danieldegrasse/Flexboard/BOM.xlsx

Sheet: Parts
Part | Value | Device | Package | Description | AVAILABILITY | CATEGORY | COMMENT | CONFIGURATION_POLE-THROW | CONTACT_CURRENT_RATING | CPU | DESCRIPTION | DIGI-KEY_PART_NUMBER | EU_ROHS_COMPLIANCE | FLASHKB | MANUFACTURER | MANUFACTURER_PART_NUMBER | MAXFREQUENCY | MF | MP | MPN | OC_FARNELL | OC_NEWARK | OPERATING_TEMP | PACKAGE | PART_STATUS | PINCOUNT | POPULARITY | POWER_RATING | PRICE | PURCHASE-URL | RATING | RESISTANCE | ROHS_COMPLIANT | SERIES | SRAMKB | SUB-CATEGORY | THERMALLOSS | TOLERANCE | TP_SIGNAL_NAME | TYPE | VENDOR | VOLTAGE_RATING
C1 | 1000pF | C1206C102K1RACAUTO | CAPC3216X110N | Cap Ceramic 0.001uF 100V X7R 10% SMD 1206 125°C Plastic T/R Check availability | In Stock |  |  |  |  |  | 1000 pF ±10% 100V Ceramic Capacitor X7R 1206 (3216 Metric) |  |  |  |  |  |  | KEMET | C1206C102K1RACAUTO |  |  |  |  | 1206 KEMET |  |  |  |  | None | https://pricing.snapeda.com/search/part/C1206C102K1RACAUTO/?ref=eda
C2 | 1uF | GCM31MR71H105KA55L | CAPC3216X125N | None Check availability | In Stock |  |  |  |  |  | SMD Capacitor X7R(EIA) with Capacitance: 1.0uF Tol. 10%. Rated Voltage: 50Vdc |  |  |  |  |  |  | Murata | GCM31MR71H105KA55L |  |  |  |  | 1206 Murata |  |  |  |  | None | https://pricing.snapeda.com/search/part/GCM31MR71H105KA55L/?ref=eda
C3 | 1uF | GCM31MR71H105KA55L | CAPC3216X125N | None Check availability | In Stock |  |  |  |  |  | SMD Capacitor X7R(EIA) with Capacitance: 1.0uF Tol. 10%. Rated Voltage: 50Vdc |  |  |  |  |  |  | Murata | GCM31MR71H105KA55L |  |  |  |  | 1206 Murata |  |  |  |  | None | https://pricing.snapeda.com/search/part/GCM31MR71H105KA55L/?ref=eda
C4 | 1uF | GCM31MR71H105KA55L | CAPC3216X125N | None Check availability | In Stock |  |  |  |  |  | SMD Capacitor X7R(EIA) with Capacitance: 1.0uF Tol. 10%. Rated Voltage: 50Vdc |  |  |  |  |  |  | Murata | GCM31MR71H105KA55L |  |  |  |  | 1206 Murata |  |  |  |  | None | https://pricing.snapeda.com/search/part/GCM31MR71H105KA55L/?ref=eda
C5 | 100nF | C1206C104K5RAC7800 | CAPC3216X88N | Cap Ceramic 0.1uF 50V X7R 10% SMD 1206 125C Plastic T/R Check availability | In Stock |  |  |  |  |  | 0.1 µF ±10% 50V Ceramic Capacitor X7R 1206 (3216 Metric) |  |  |  |  |  |  | KEMET | C1206C104K5RAC7800 |  |  |  |  | 3216 KEMET |  |  |  |  | None | https://pricing.snapeda.com/search/part/C1206C104K5RAC7800/?ref=eda
C6 | 100nF | C1206C104K5RAC7800 | CAPC3216X88N | Cap Ceramic 0.1uF 50V X7R 10% SMD 1206 125C Plastic T/R Check availability | In Stock |  |  |  |  |  | 0.1 µF ±10% 50V Ceramic Capacitor X7R 1206 (3216 Metric) |  |  |  |  |  |  | KEMET | C1206C104K5RAC7800 |  |  |  |  | 3216 KEMET |  |  |  |  | None | https://pricing.snapeda.com/search/part/C1206C104K5RAC7800/?ref=eda
C7 | 100nF | C1206C104K5RAC7800 | CAPC3216X88N | Cap Ceramic 0.1uF 50V X7R 10% SMD 1206 125C Plastic T/R Check availability | In Stock |  |  |  |  |  | 0.1 µF ±10% 50V Ceramic Capacitor X7R 1206 (3216 Metric) |  |  |  |  |  |  | KEMET | C1206C104K5RAC7800 |  |  |  |  | 3216 KEMET |  |  |  |  | None | https://pricing.snapeda.com/search/part/C1206C104K5RAC7800/?ref=eda
C8 | 1uF | GCM31MR71H105KA55L | CAPC3216X125N | None Check availability | In Stock |  |  |  |  |  | SMD Capacitor X7R(EIA) with Capacitance: 1.0uF Tol. 10%. Rated Voltage: 50Vdc |  |  |  |  |  |  | Murata | GCM31MR71H105KA55L |  |  |  |  | 1206 Murata |  |  |  |  | None | https://pricing.snapeda.com/search/part/GCM31MR71H105KA55L/?ref=eda
C9 | 100nF | C1206C104K5RAC7800 | CAPC3216X88N | Cap Ceramic 0.1uF 50V X7R 10% SMD 1206 125C Plastic T/R Check availability | In Stock |  |  |  |  |  | 0.1 µF ±10% 50V Ceramic Capacitor X7R 1206 (3216 Metric) |  |  |  |  |  |  | KEMET | C1206C104K5RAC7800 |  |  |  |  | 3216 KEMET |  |  |  |  | None | https://pricing.snapeda.com/search/part/C1206C104K5RAC7800/?ref=eda
C10 | 22pF | C1206C220JGGAC7800 | CAPC3216X110N | Check availability | In Stock |  |  |  |  |  | CAP CER 22PF 2KV NP0 1206 |  |  |  |  |  |  | KEMET | C1206C220JGGAC7800 |  |  |  |  | 3216 KEMET |  |  |  |  | None
C11 | 22pF | C1206C220JGGAC7800 | CAPC3216X110N | Check availability | In Stock |  |  |  |  |  | CAP CER 22PF 2KV NP0 1206 |  |  |  |  |  |  | KEMET | C1206C220JGGAC7800 |  |  |  |  | 3216 KEMET |  |  |  |  | None
C12 | 2.2uF | 1206ZC225MAT2A | CAPC3216X178N | CERAMIC CAPACITOR, 2.2UF, 10V, X7R, 20%, 1206, FULL REEL Check availability | In Stock |  |  |  |  |  | 2.2 µF ±20% 10V Ceramic Capacitor X7R 1206 (3216 Metric) |  |  |  |  |  |  | AVX | 1206ZC225MAT2A |  |  |  |  | 3216 AVX |  |  |  |  | None | https://pricing.snapeda.com/search/part/1206ZC225MAT2A/?ref=eda
C13 | 10uF | GRM21BC8YA106ME11L | CAPC2012X145N | Cap Ceramic 10uF 35V X6S 20% Pad SMD 0805 105C T/R |  |  |  |  |  |  | 0805 10 uF 35 V ±20% Tolerance X6S Multilayer Ceramic Capacitor | 490-10505-2-ND |  |  |  |  |  | Murata | GRM21BC8YA106ME11L |  |  |  |  | 2012 Murata |  |  |  |  |  | https://pricing.snapeda.com/search/part/GRM21BC8YA106ME11L/?ref=eda
C14 | 10uF | GRM21BC8YA106ME11L | CAPC2012X145N | Cap Ceramic 10uF 35V X6S 20% Pad SMD 0805 105C T/R |  |  |  |  |  |  | 0805 10 uF 35 V ±20% Tolerance X6S Multilayer Ceramic Capacitor | 490-10505-2-ND |  |  |  |  |  | Murata | GRM21BC8YA106ME11L |  |  |  |  | 2012 Murata |  |  |  |  |  | https://pricing.snapeda.com/search/part/GRM21BC8YA106ME11L/?ref=eda
C15 | 1000pF | C1206C102K1RACAUTO | CAPC3216X110N | Cap Ceramic 0.001uF 100V X7R 10% SMD 1206 125°C Plastic T/R Check availability | In Stock |  |  |  |  |  | 1000 pF ±10% 100V Ceramic Capacitor X7R 1206 (3216 Metric) |  |  |  |  |  |  | KEMET | C1206C102K1RACAUTO |  |  |  |  | 1206 KEMET |  |  |  |  | None | https://pricing.snapeda.com/search/part/C1206C102K1RACAUTO/?ref=eda
C16 | 0.47uF | C_CHIP-0805(2012-METRIC) | CAPC2012X110 | Capacitor - Generic |  | Capacitor
C17 | 0.47uF | C_CHIP-0805(2012-METRIC) | CAPC2012X110 | Capacitor - Generic |  | Capacitor
C18 | 0.1uF | C_CHIP-0805(2012-METRIC) | CAPC2012X110 | Capacitor - Generic |  | Capacitor
C19 | 0.47uF | C_CHIP-0805(2012-METRIC) | CAPC2012X110 | Capacitor - Generic |  | Capacitor
C20 | 0.1uF | C_CHIP-0805(2012-METRIC) | CAPC2012X110 | Capacitor - Generic |  | Capacitor
C21 | 0.47uF | C_CHIP-0805(2012-METRIC) | CAPC2012X110 | Capacitor - Generic |  | Capacitor
C22 | 0.1uF | C_CHIP-0805(2012-METRIC) | CAPC2012X110 | Capacitor - Generic |  | Capacitor
C23 | 22uF | 860020672011 | 860020672011 | 22uF 50V Electrolytic Capacitor Wurth 860020672011
C24 | 12pF | C_CHIP-0805(2012-METRIC) | CAPC2012X110 | Capacitor - Generic |  | Capacitor
C25 | 12pF | C_CHIP-0805(2012-METRIC) | CAPC2012X110 | Capacitor - Generic |  | Capacitor
D1 | BAS16LT3G | BAS16LT3G | SOT95P240X111-3N | Diode Small Signal Switching 100V 0.2A Automotive 3-Pin SOT-23 T/R Check prices | In Stock |  |  |  |  |  | Diode Standard 100V 200mA (DC) Surface Mount SOT-23-3 (TO-236) |  |  |  |  |  |  | ON Semiconductor | BAS16LT3G |  |  |  |  | SOT-23-3 ON Semiconductor |  |  |  |  | None
D2 | BAS16LT3G | BAS16LT3G | SOT95P240X111-3N | Diode Small Signal Switching 100V 0.2A Automotive 3-Pin SOT-23 T/R Check prices | In Stock |  |  |  |  |  | Diode Standard 100V 200mA (DC) Surface Mount SOT-23-3 (TO-236) |  |  |  |  |  |  | ON Semiconductor | BAS16LT3G |  |  |  |  | SOT-23-3 ON Semiconductor |  |  |  |  | None
D3 | BAS16LT3G | BAS16LT3G | SOT95P240X111-3N | Diode Small Signal Switching 100V 0.2A Automotive 3-Pin SOT-23 T/R Check prices | In Stock |  |  |  |  |  | Diode Standard 100V 200mA (DC) Surface Mount SOT-23-3 (TO-236) |  |  |  |  |  |  | ON Semiconductor | BAS16LT3G |  |  |  |  | SOT-23-3 ON Semiconductor |  |  |  |  | None
D4 | BAS16LT3G | BAS16LT3G | SOT95P240X111-3N | Diode Small Signal Switching 100V 0.2A Automotive 3-Pin SOT-23 T/R Check prices | In Stock |  |  |  |  |  | Diode Standard 100V 200mA (DC) Surface Mount SOT-23-3 (TO-236) |  |  |  |  |  |  | ON Semiconductor | BAS16LT3G |  |  |  |  | SOT-23-3 ON Semiconductor |  |  |  |  | None
D5 | BAS16LT3G | BAS16LT3G | SOT95P240X111-3N | Diode Small Signal Switching 100V 0.2A Automotive 3-Pin SOT-23 T/R Check prices | In Stock |  |  |  |  |  | Diode Standard 100V 200mA (DC) Surface Mount SOT-23-3 (TO-236) |  |  |  |  |  |  | ON Semiconductor | BAS16LT3G |  |  |  |  | SOT-23-3 ON Semiconductor |  |  |  |  | None
D6 | BAS16LT3G | BAS16LT3G | SOT95P240X111-3N | Diode Small Signal Switching 100V 0.2A Automotive 3-Pin SOT-23 T/R Check prices | In Stock |  |  |  |  |  | Diode Standard 100V 200mA (DC) Surface Mount SOT-23-3 (TO-236) |  |  |  |  |  |  | ON Semiconductor | BAS16LT3G |  |  |  |  | SOT-23-3 ON Semiconductor |  |  |  |  | None
D7 | BAS16LT3G | BAS16LT3G | SOT95P240X111-3N | Diode Small Signal Switching 100V 0.2A Automotive 3-Pin SOT-23 T/R Check prices | In Stock |  |  |  |  |  | Diode Standard 100V 200mA (DC) Surface Mount SOT-23-3 (TO-236) |  |  |  |  |  |  | ON Semiconductor | BAS16LT3G |  |  |  |  | SOT-23-3 ON Semiconductor |  |  |  |  | None
D8 | BAS16LT3G | BAS16LT3G | SOT95P240X111-3N | Diode Small Signal Switching 100V 0.2A Automotive 3-Pin SOT-23 T/R Check prices | In Stock |  |  |  |  |  | Diode Standard 100V 200mA (DC) Surface Mount SOT-23-3 (TO-236) |  |  |  |  |  |  | ON Semiconductor | BAS16LT3G |  |  |  |  | SOT-23-3 ON Semiconductor |  |  |  |  | None
D9 | BAS16LT3G | BAS16LT3G | SOT95P240X111-3N | Diode Small Signal Switching 100V 0.2A Automotive 3-Pin SOT-23 T/R Check prices | In Stock |  |  |  |  |  | Diode Standard 100V 200mA (DC) Surface Mount SOT-23-3 (TO-236) |  |  |  |  |  |  | ON Semiconductor | BAS16LT3G |  |  |  |  | SOT-23-3 ON Semiconductor |  |  |  |  | None
D10 | BAS16LT3G | BAS16LT3G | SOT95P240X111-3N | Diode Small Signal Switching 100V 0.2A Automotive 3-Pin SOT-23 T/R Check prices | In Stock |  |  |  |  |  | Diode Standard 100V 200mA (DC) Surface Mount SOT-23-3 (TO-236) |  |  |  |  |  |  | ON Semiconductor | BAS16LT3G |  |  |  |  | SOT-23-3 ON Semiconductor |  |  |  |  | None
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
D151 | BAS16LT3G | BAS16LT3G | SOT95P240X111-3N | Diode Small Signal Switching 100V 0.2A Automotive 3-Pin SOT-23 T/R Check prices | In Stock |  |  |  |  |  | Diode Standard 100V 200mA (DC) Surface Mount SOT-23-3 (TO-236) |  |  |  |  |  |  | ON Semiconductor | BAS16LT3G |  |  |  |  | SOT-23-3 ON Semiconductor |  |  |  |  | None
D152 | BAS16LT3G | BAS16LT3G | SOT95P240X111-3N | Diode Small Signal Switching 100V 0.2A Automotive 3-Pin SOT-23 T/R Check prices | In Stock |  |  |  |  |  | Diode Standard 100V 200mA (DC) Surface Mount SOT-23-3 (TO-236) |  |  |  |  |  |  | ON Semiconductor | BAS16LT3G |  |  |  |  | SOT-23-3 ON Semiconductor |  |  |  |  | None
D153 | BAS16LT3G | BAS16LT3G | SOT95P240X111-3N | Diode Small Signal Switching 100V 0.2A Automotive 3-Pin SOT-23 T/R Check prices | In Stock |  |  |  |  |  | Diode Standard 100V 200mA (DC) Surface Mount SOT-23-3 (TO-236) |  |  |  |  |  |  | ON Semiconductor | BAS16LT3G |  |  |  |  | SOT-23-3 ON Semiconductor |  |  |  |  | None
D154 | LSM115JE3/TR13 | LSM115JE3/TR13 | LSM115JE3/TR13 | LSM115JE3/TR13
GND1 | TPB2,54 | TPB2,54 | B2,54 | Test pad |  |  |  |  |  |  |  |  |  |  |  |  |  |  |  |  |  |  |  |  |  |  | 3
GND2 | TPB2,54 | TPB2,54 | B2,54 | Test pad |  |  |  |  |  |  |  |  |  |  |  |  |  |  |  |  |  |  |  |  |  |  | 3
GND3 | TPB2,54 | TPB2,54 | B2,54 | Test pad |  |  |  |  |  |  |  |  |  |  |  |  |  |  |  |  |  |  |  |  |  |  | 3
GND4 | TPB2,54 | TPB2,54 | B2,54 | Test pad |  |  |  |  |  |  |  |  |  |  |  |  |  |  |  |  |  |  |  |  |  |  | 3
J1 | USB4105-GF-A | USB4105-GF-A | GCT_USB4105-GF-A | USB-C (USB TYPE-C) USB 2.0 Receptacle Connector 24 (16+8 Dummy) Position Surface Mount, Right Angle; Through Hole Check availability | In Stock |  |  |  |  |  | USB-C (USB TYPE-C) USB 2.0 Receptacle Connector 24 (16+8 Dummy) Position Surface Mount, Right Angle | Through Hole |  |  |  |  |  |  | GCT | USB4105-GF-A |  |  |  |  | None |  |  |  |  | None | https://pricing.snapeda.com/search/part/USB4105-GF-A/?ref=eda
J2 | GRPB052VWQS-RC | GRPB052VWQS-RC | DEBUG | CONN HEADER 0.050" 10PS DL SMD AU | In Stock |  |  |  |  |  | Connector Header Surface Mount 10 position 0.050 (1.27mm) |  |  |  |  |  |  | Sullins Connector | GRPB052VWQS-RC |  |  |  |  | None |  |  |  |  | None | https://pricing.snapeda.com/search/part/GRPB052VWQS-RC/?ref=eda
KEY_1 | CHERRY-MX-LED | CHERRY-MX-LED | CHERRY-MX-LED | Cherry MX series keyswitch with LED
KEY_2 | CHERRY-MX-LED | CHERRY-MX-LED | CHERRY-MX-LED | Cherry MX series keyswitch with LED
KEY_3 | CHERRY-MX-LED | CHERRY-MX-LED | CHERRY-MX-LED | Cherry MX series keyswitch with LED
KEY_4 | CHERRY-MX-LED | CHERRY-MX-LED | CHERRY-MX-LED | Cherry MX series keyswitch with LED
KEY_5 | CHERRY-MX-LED | CHERRY-MX-LED | CHERRY-MX-LED | Cherry MX series keyswitch with LED
KEY_6 | CHERRY-MX-LED | CHERRY-MX-LED | CHERRY-MX-LED | Cherry MX series keyswitch with LED
KEY_7 | CHERRY-MX-LED | CHERRY-MX-LED | CHERRY-MX-LED | Cherry MX series keyswitch with LED
KEY_8 | CHERRY-MX-LED | CHERRY-MX-LED | CHERRY-MX-LED | Cherry MX series keyswitch with LED
KEY_9 | CHERRY-MX-LED | CHERRY-MX-LED | CHERRY-MX-LED | Cherry MX series keyswitch with LED
KEY_10 | CHERRY-MX-LED | CHERRY-MX-LED | CHERRY-MX-LED | Cherry MX series keyswitch with LED
KEY_11 | CHERRY-MX-LED | CHERRY-MX-LED | CHERRY-MX-LED | Cherry MX series keyswitch with LED
KEY_12 | CHERRY-MX-LED | CHERRY-MX-LED | CHERRY-MX-LED | Cherry MX series keyswitch with LED
KEY_13 | CHERRY-MX-LED | CHERRY-MX-LED | CHERRY-MX-LED | Cherry MX series keyswitch with LED
KEY_14 | CHERRY-MX-LED | CHERRY-MX-LED | CHERRY-MX-LED | Cherry MX series keyswitch with LED
KEY_15 | CHERRY-MX-LED | CHERRY-MX-LED | CHERRY-MX-LED | Cherry MX series keyswitch with LED
KEY_16 | CHERRY-MX-LED | CHERRY-MX-LED | CHERRY-MX-LED | Cherry MX series keyswitch with LED
KEY_17 | CHERRY-MX-LED | CHERRY-MX-LED | CHERRY-MX-LED | Cherry MX series keyswitch with LED
KEY_18 | CHERRY-MX-LED | CHERRY-MX-LED | CHERRY-MX-LED | Cherry MX series keyswitch with LED
KEY_19 | CHERRY-MX-LED | CHERRY-MX-LED | CHERRY-MX-LED | Cherry MX series keyswitch with LED
KEY_20 | CHERRY-MX-LED | CHERRY-MX-LED | CHERRY-MX-LED | Cherry MX series keyswitch with LED
KEY_21 | CHERRY-MX-LED | CHERRY-MX-LED | CHERRY-MX-LED | Cherry MX series keyswitch with LED
KEY_22 | CHERRY-MX-LED | CHERRY-MX-LED | CHERRY-MX-LED | Cherry MX series keyswitch with LED
KEY_23 | CHERRY-MX-LED | CHERRY-MX-LED | CHERRY-MX-LED | Cherry MX series keyswitch with LED
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
KEY_126 | CHERRY-MX-LED | CHERRY-MX-LED | CHERRY-MX-LED | Cherry MX series keyswitch with LED
KEY_127 | CHERRY-MX-LED | CHERRY-MX-LED | CHERRY-MX-LED | Cherry MX series keyswitch with LED
KEY_128 | CHERRY-MX-LED | CHERRY-MX-LED | CHERRY-MX-LED | Cherry MX series keyswitch with LED
KEY_129 | CHERRY-MX-LED | CHERRY-MX-LED | CHERRY-MX-LED | Cherry MX series keyswitch with LED
KEY_130 | CHERRY-MX-LED | CHERRY-MX-LED | CHERRY-MX-LED | Cherry MX series keyswitch with LED
KEY_131 | CHERRY-MX-LED | CHERRY-MX-LED | CHERRY-MX-LED | Cherry MX series keyswitch with LED
KEY_132 | CHERRY-MX-LED | CHERRY-MX-LED | CHERRY-MX-LED | Cherry MX series keyswitch with LED
KEY_133 | CHERRY-MX-LED | CHERRY-MX-LED | CHERRY-MX-LED | Cherry MX series keyswitch with LED
KEY_134 | CHERRY-MX-LED | CHERRY-MX-LED | CHERRY-MX-LED | Cherry MX series keyswitch with LED
KEY_135 | CHERRY-MX-LED | CHERRY-MX-LED | CHERRY-MX-LED | Cherry MX series keyswitch with LED
KEY_136 | CHERRY-MX-LED | CHERRY-MX-LED | CHERRY-MX-LED | Cherry MX series keyswitch with LED
KEY_137 | CHERRY-MX-LED | CHERRY-MX-LED | CHERRY-MX-LED | Cherry MX series keyswitch with LED
KEY_138 | CHERRY-MX-LED | CHERRY-MX-LED | CHERRY-MX-LED | Cherry MX series keyswitch with LED
KEY_139 | CHERRY-MX-LED | CHERRY-MX-LED | CHERRY-MX-LED | Cherry MX series keyswitch with LED
KEY_140 | CHERRY-MX-LED | CHERRY-MX-LED | CHERRY-MX-LED | Cherry MX series keyswitch with LED
KEY_141 | CHERRY-MX-LED | CHERRY-MX-LED | CHERRY-MX-LED | Cherry MX series keyswitch with LED
KEY_142 | CHERRY-MX-LED | CHERRY-MX-LED | CHERRY-MX-LED | Cherry MX series keyswitch with LED
KEY_143 | CHERRY-MX-LED | CHERRY-MX-LED | CHERRY-MX-LED | Cherry MX series keyswitch with LED
KEY_144 | CHERRY-MX-LED | CHERRY-MX-LED | CHERRY-MX-LED | Cherry MX series keyswitch with LED
KEY_145 | CHERRY-MX-LED | CHERRY-MX-LED | CHERRY-MX-LED | Cherry MX series keyswitch with LED
KEY_146 | CHERRY-MX-LED | CHERRY-MX-LED | CHERRY-MX-LED | Cherry MX series keyswitch with LED
KEY_147 | CHERRY-MX-LED | CHERRY-MX-LED | CHERRY-MX-LED | Cherry MX series keyswitch with LED
KEY_148 | CHERRY-MX-LED | CHERRY-MX-LED | CHERRY-MX-LED | Cherry MX series keyswitch with LED
KEY_149 | CHERRY-MX-LED | CHERRY-MX-LED | CHERRY-MX-LED | Cherry MX series keyswitch with LED
KEY_150 | CHERRY-MX-LED | CHERRY-MX-LED | CHERRY-MX-LED | Cherry MX series keyswitch with LED
KEY_151 | CHERRY-MX-LED | CHERRY-MX-LED | CHERRY-MX-LED | Cherry MX series keyswitch with LED
KEY_152 | CHERRY-MX-LED | CHERRY-MX-LED | CHERRY-MX-LED | Cherry MX series keyswitch with LED
KEY_153 | CHERRY-MX-LED | CHERRY-MX-LED | CHERRY-MX-LED | Cherry MX series keyswitch with LED
L1 | 330 | 782853331SMD | 78285333 | 782853331
L2 | 330 | 782853331SMD | 78285333 | 782853331
R1 | 10k | CRGCQ1206J10K | RESC3115X65N | Fixed Resistor CRGCQ 1206 10K 5% Check availability | In Stock |  | 2-2176344-5 |  |  |  | Fixed Resistor CRGCQ 1206 10K 5% |  |  |  |  |  |  | TE Connectivity | CRGCQ1206J10K |  |  |  |  | 3115 TE Connectivity |  |  |  |  | None | https://pricing.snapeda.com/search/part/CRGCQ1206J10K/?ref=eda
R2 | 33 | CRG0805F33R | RESC2012X65N | Fixed Resistors Check availability | In Stock |  | 1623198-1 |  |  |  | Fixed Resistors |  | Compliant with Exemptions |  |  |  |  | TE Connectivity | CRG0805F33R |  |  |  |  | 805 |  |  |  | .125 W | None | https://pricing.snapeda.com/search/part/CRG0805F33R/?ref=eda |  | 33 |  |  |  |  |  | 1% |  |  |  | 150 V
R3 | 33 | CRG0805F33R | RESC2012X65N | Fixed Resistors Check availability | In Stock |  | 1623198-1 |  |  |  | Fixed Resistors |  | Compliant with Exemptions |  |  |  |  | TE Connectivity | CRG0805F33R |  |  |  |  | 805 |  |  |  | .125 W | None | https://pricing.snapeda.com/search/part/CRG0805F33R/?ref=eda |  | 33 |  |  |  |  |  | 1% |  |  |  | 150 V
R4 | 210K | R-US_CHIP-0805(2012-METRIC) | RESC2012X65 | Resistor Fixed - ANSI |  | Resistor |  |  |  |  |  |  |  |  |  |  |  |  |  |  |  |  |  |  |  |  |  |  |  |  |  |  |  |  |  | Fixed
R5 | 4.7K | R-US_CHIP-0805(2012-METRIC) | RESC2012X65 | Resistor Fixed - ANSI |  | Resistor |  |  |  |  |  |  |  |  |  |  |  |  |  |  |  |  |  |  |  |  |  |  |  |  |  |  |  |  |  | Fixed
R6 | 4.7K | R-US_CHIP-0805(2012-METRIC) | RESC2012X65 | Resistor Fixed - ANSI |  | Resistor |  |  |  |  |  |  |  |  |  |  |  |  |  |  |  |  |  |  |  |  |  |  |  |  |  |  |  |  |  | Fixed
R7 | 100K | R-US_CHIP-0805(2012-METRIC) | RESC2012X65 | Resistor Fixed - ANSI |  | Resistor |  |  |  |  |  |  |  |  |  |  |  |  |  |  |  |  |  |  |  |  |  |  |  |  |  |  |  |  |  | Fixed
R8 | 100K | R-US_CHIP-0805(2012-METRIC) | RESC2012X65 | Resistor Fixed - ANSI |  | Resistor |  |  |  |  |  |  |  |  |  |  |  |  |  |  |  |  |  |  |  |  |  |  |  |  |  |  |  |  |  | Fixed
R9 | 100K | R-US_CHIP-0805(2012-METRIC) | RESC2012X65 | Resistor Fixed - ANSI |  | Resistor |  |  |  |  |  |  |  |  |  |  |  |  |  |  |  |  |  |  |  |  |  |  |  |  |  |  |  |  |  | Fixed
R11 | 10k | CRGCQ1206J10K | RESC3115X65N | Fixed Resistor CRGCQ 1206 10K 5% Check availability | In Stock |  | 2-2176344-5 |  |  |  | Fixed Resistor CRGCQ 1206 10K 5% |  |  |  |  |  |  | TE Connectivity | CRGCQ1206J10K |  |  |  |  | 3115 TE Connectivity |  |  |  |  | None | https://pricing.snapeda.com/search/part/CRGCQ1206J10K/?ref=eda
R12 | 5.1k | RNCP0805FTD20R0 | RESC2012X60N | Check availability | In Stock |  |  |  |  |  | 20 Ohms ±1% 0.25W, 1/4W Chip Resistor 0805 (2012 Metric) Anti-Sulfur, Moisture Resistant Thin Film |  |  |  |  |  |  | Stackpole Electronics Inc | RNCP0805FTD20R0 |  |  |  |  | 2012 Stackpole |  |  |  |  | None | https://pricing.snapeda.com/search/part/RNCP0805FTD20R0/?ref=eda
R13 | 5.1k | RNCP0805FTD20R0 | RESC2012X60N | Check availability | In Stock |  |  |  |  |  | 20 Ohms ±1% 0.25W, 1/4W Chip Resistor 0805 (2012 Metric) Anti-Sulfur, Moisture Resistant Thin Film |  |  |  |  |  |  | Stackpole Electronics Inc | RNCP0805FTD20R0 |  |  |  |  | 2012 Stackpole |  |  |  |  | None | https://pricing.snapeda.com/search/part/RNCP0805FTD20R0/?ref=eda
SCL | TPB2,54 | TPB2,54 | B2,54 | Test pad |  |  |  |  |  |  |  |  |  |  |  |  |  |  |  |  |  |  |  |  |  |  | 3
SDA | TPB2,54 | TPB2,54 | B2,54 | Test pad |  |  |  |  |  |  |  |  |  |  |  |  |  |  |  |  |  |  |  |  |  |  | 3
SJ1 |  | SJ2W | SJ_2 | SMD solder JUMPER |  |  |  |  |  |  |  |  |  |  |  |  |  |  |  |  |  |  |  |  |  |  | 7
SJ2 |  | SJW | SJW | SMD solder JUMPER |  |  |  |  |  |  |  |  |  |  |  |  |  |  |  |  |  |  |  |  |  |  | 3
SJ3 |  | SJW | SJW | SMD solder JUMPER |  |  |  |  |  |  |  |  |  |  |  |  |  |  |  |  |  |  |  |  |  |  | 3
SJ4 |  | SJW | SJW | SMD solder JUMPER |  |  |  |  |  |  |  |  |  |  |  |  |  |  |  |  |  |  |  |  |  |  | 3
SJ5 |  | SJW | SJW | SMD solder JUMPER |  |  |  |  |  |  |  |  |  |  |  |  |  |  |  |  |  |  |  |  |  |  | 3
SJ6 |  | SJW | SJW | SMD solder JUMPER |  |  |  |  |  |  |  |  |  |  |  |  |  |  |  |  |  |  |  |  |  |  | 3
SJ7 |  | SJW | SJW | SMD solder JUMPER |  |  |  |  |  |  |  |  |  |  |  |  |  |  |  |  |  |  |  |  |  |  | 3
SJ8 |  | SJW | SJW | SMD solder JUMPER |  |  |  |  |  |  |  |  |  |  |  |  |  |  |  |  |  |  |  |  |  |  | 3
SJ9 |  | SJW | SJW | SMD solder JUMPER |  |  |  |  |  |  |  |  |  |  |  |  |  |  |  |  |  |  |  |  |  |  | 3
SJ10 |  | SJW | SJW | SMD solder JUMPER |  |  |  |  |  |  |  |  |  |  |  |  |  |  |  |  |  |  |  |  |  |  | 3
SJ11 |  | SJW | SJW | SMD solder JUMPER |  |  |  |  |  |  |  |  |  |  |  |  |  |  |  |  |  |  |  |  |  |  | 3
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
SJ_MCU_COL14 | JUMPER-SMT_2_NC_TRACE_NO-SILK | JUMPER-SMT_2_NC_TRACE_NO-SILK | SMT-JUMPER_2_NC_TRACE_NO-SILK | Normally closed trace jumper
SJ_MCU_COL15 | JUMPER-SMT_2_NC_TRACE_NO-SILK | JUMPER-SMT_2_NC_TRACE_NO-SILK | SMT-JUMPER_2_NC_TRACE_NO-SILK | Normally closed trace jumper
SJ_MCU_COL16 | JUMPER-SMT_2_NC_TRACE_NO-SILK | JUMPER-SMT_2_NC_TRACE_NO-SILK | SMT-JUMPER_2_NC_TRACE_NO-SILK | Normally closed trace jumper
SJ_MCU_COL17 | JUMPER-SMT_2_NC_TRACE_NO-SILK | JUMPER-SMT_2_NC_TRACE_NO-SILK | SMT-JUMPER_2_NC_TRACE_NO-SILK | Normally closed trace jumper
SJ_MCU_COL18 | JUMPER-SMT_2_NC_TRACE_NO-SILK | JUMPER-SMT_2_NC_TRACE_NO-SILK | SMT-JUMPER_2_NC_TRACE_NO-SILK | Normally closed trace jumper
SJ_MCU_COL19 | JUMPER-SMT_2_NC_TRACE_NO-SILK | JUMPER-SMT_2_NC_TRACE_NO-SILK | SMT-JUMPER_2_NC_TRACE_NO-SILK | Normally closed trace jumper
SJ_MCU_COL20 | JUMPER-SMT_2_NC_TRACE_NO-SILK | JUMPER-SMT_2_NC_TRACE_NO-SILK | SMT-JUMPER_2_NC_TRACE_NO-SILK | Normally closed trace jumper
SJ_MCU_COL21 | JUMPER-SMT_2_NC_TRACE_NO-SILK | JUMPER-SMT_2_NC_TRACE_NO-SILK | SMT-JUMPER_2_NC_TRACE_NO-SILK | Normally closed trace jumper
SJ_MCU_COL22 | JUMPER-SMT_2_NC_TRACE_NO-SILK | JUMPER-SMT_2_NC_TRACE_NO-SILK | SMT-JUMPER_2_NC_TRACE_NO-SILK | Normally closed trace jumper
SJ_MCU_COL23 | JUMPER-SMT_2_NC_TRACE_NO-SILK | JUMPER-SMT_2_NC_TRACE_NO-SILK | SMT-JUMPER_2_NC_TRACE_NO-SILK | Normally closed trace jumper
SJ_MCU_COL24 | JUMPER-SMT_2_NC_TRACE_NO-SILK | JUMPER-SMT_2_NC_TRACE_NO-SILK | SMT-JUMPER_2_NC_TRACE_NO-SILK | Normally closed trace jumper
SJ_MCU_ROW1 | JUMPER-SMT_2_NC_TRACE_NO-SILK | JUMPER-SMT_2_NC_TRACE_NO-SILK | SMT-JUMPER_2_NC_TRACE_NO-SILK | Normally closed trace jumper
SJ_MCU_ROW2 | JUMPER-SMT_2_NC_TRACE_NO-SILK | JUMPER-SMT_2_NC_TRACE_NO-SILK | SMT-JUMPER_2_NC_TRACE_NO-SILK | Normally closed trace jumper
SJ_MCU_ROW3 | JUMPER-SMT_2_NC_TRACE_NO-SILK | JUMPER-SMT_2_NC_TRACE_NO-SILK | SMT-JUMPER_2_NC_TRACE_NO-SILK | Normally closed trace jumper
SJ_MCU_ROW4 | JUMPER-SMT_2_NC_TRACE_NO-SILK | JUMPER-SMT_2_NC_TRACE_NO-SILK | SMT-JUMPER_2_NC_TRACE_NO-SILK | Normally closed trace jumper
SJ_MCU_ROW5 | JUMPER-SMT_2_NC_TRACE_NO-SILK | JUMPER-SMT_2_NC_TRACE_NO-SILK | SMT-JUMPER_2_NC_TRACE_NO-SILK | Normally closed trace jumper
SJ_MCU_ROW6 | JUMPER-SMT_2_NC_TRACE_NO-SILK | JUMPER-SMT_2_NC_TRACE_NO-SILK | SMT-JUMPER_2_NC_TRACE_NO-SILK | Normally closed trace jumper
SJ_MCU_ROW7 | JUMPER-SMT_2_NC_TRACE_NO-SILK | JUMPER-SMT_2_NC_TRACE_NO-SILK | SMT-JUMPER_2_NC_TRACE_NO-SILK | Normally closed trace jumper
SV1 |  | MA04-1 | MA04-1 | PIN HEADER |  |  |  |  |  |  |  |  |  |  |  |  |  |  |  |  | unknown | unknown |  |  |  |  | 41
SW1 | 1825910-7 | 1825910-7 | SW_1825910-7 | Switch Tactile OFF (ON) SPST Round Button PC Pins 0.05A 24VDC 100000Cycles 2.55N Thru-Hole Loose Check availability | In Stock |  | 1825910-7 | Single Pole - Single Throw | 50 mA |  | Switch Tactile OFF (ON) SPST Round Button PC Pins 0.05A 24VDC 100000Cycle 2.55N Thru-Hole Loose Piece |  | Compliant |  |  |  |  | TE Connectivity | 1825910-7 |  |  |  |  | None |  |  |  |  | None | https://pricing.snapeda.com/search/part/1825910-7/?ref=eda
TVS1 |  | 0603ESDA2-TR2 | 0603ESDA2-TR2 | TVS 0603ESDA2-TR2
TVS2 |  | 0603ESDA2-TR2 | 0603ESDA2-TR2 | TVS 0603ESDA2-TR2
TVS3 |  | 0603ESDA2-TR2 | 0603ESDA2-TR2 | TVS 0603ESDA2-TR2
U1 | MK22FX512VLQ12 | MK22FX512AVLQ12 | LQFP-144_20X20X1.6 |  |  |  |  |  |  | ARM Cortex-M4 |  |  |  | 512 |  | MK22FX512AVLQ12 | 120 |  |  |  |  |  |  |  |  | 144 |  |  |  |  |  |  |  |  | 128 |  |  |  |  |  | NXP
U2 | AP2115M-3.3TRG1 | AP2115M-3.3TRG1 | SOIC127P600X175-8N | AP2115M-3.3TRG1
U3 | IS31FL3733B-TQLS4 | IS31FL3733B-TQLS4 | IS31FL3733B-TQLS4 | IS31FL3733B
VDD_3V3 | TPB2,54 | TPB2,54 | B2,54 | Test pad |  |  |  |  |  |  |  |  |  |  |  |  |  |  |  |  |  |  |  |  |  |  | 3
VLDO_5V | TPB2,54 | TPB2,54 | B2,54 | Test pad |  |  |  |  |  |  |  |  |  |  |  |  |  |  |  |  |  |  |  |  |  |  | 3
Y1 | ABM3B-8.000MHZ-B2-T | ABM3B-8.000MHZ-B2-T | OSC_ABM3B-8.000MHZ-B2-T | 8MHz ±20ppm Crystal 18pF 200 Ohms 4-SMD, No Lead Check availability Check availability Check availability | In Stock |  |  |  |  |  | 8 MHz ±20ppm Crystal 18pF 200 Ohms 4-SMD, No Lead |  |  |  |  |  |  | Abracon | ABM3B-8.000MHZ-B2-T |  |  |  |  | SMD-4 Abracon LLC |  |  |  |  | None | https://pricing.snapeda.com/search/part/ABM3B-8.000MHZ-B2-T/?ref=eda
Y2 | ABS07-32.768KHZ-T | ABS07-32.768KHZ-T | XTAL_ABS07-32.768KHZ-T | ABS07 Series 32.768 kHz ±20 ppm 12.5 pF -40 to +85 °C SMT Low Profile Crystal Check availability | In Stock |  |  |  |  |  | 32.768 kHz ±20ppm Crystal 12.5pF 70 kOhms 2-SMD, No Lead |  |  |  |  |  |  | Abracon | ABS07-32.768KHZ-T |  |  |  |  | SMD-2 Abracon LLC |  |  |  |  | None | https://pricing.snapeda.com/search/part/ABS07-32.768KHZ-T/?ref=eda

Sheet: Quantity
Base Qty | Min Qty | Expected Order | On Hand | Actual Order | Value | Device | Package | Parts | Mouser P/N | Stock | Cost Each | Total | Description | AVAILABILITY | CATEGORY | COMMENT | CONFIGURATION_POLE-THROW | CONTACT_CURRENT_RATING | CPU | DESCRIPTION | DIGI-KEY_PART_NUMBER | EU_ROHS_COMPLIANCE | FLASHKB | MANUFACTURER | MANUFACTURER_PART_NUMBER | MAXFREQUENCY | MF | MP | MPN | OC_FARNELL | OC_NEWARK | OPERATING_TEMP | PACKAGE | PART_STATUS | PINCOUNT | POPULARITY | POWER_RATING | PRICE | PURCHASE-URL | RATING | RESISTANCE | ROHS_COMPLIANT | SERIES | SRAMKB | SUB-CATEGORY | THERMALLOSS | TOLERANCE | TP_SIGNAL_NAME | TYPE | VENDOR | VOLTAGE_RATING
3 | 6 | 7 | 1 | 6 |  | 0603ESDA2-TR2 | 0603ESDA2-TR2 | TVS1, TVS2, TVS3 | 504-0603ESDA2-TR2 | 73301 | 0.44 | 2.64 | TVS 0603ESDA2-TR2
1 | 2 | 1 | 0 | 1 |  | MA04-1 | MA04-1 | SV1 | 710-61304011021 | 2023 | 1.45 | 1.45 | Curved PIN HEADER (40 pin, need 8 total) |  |  |  |  |  |  |  |  |  |  |  |  |  |  |  |  | unknown | unknown |  |  |  |  | 41
1 | 2 | 3 | 0 | 3 |  | SJ2W | SJ_2 | SJ1 | N/A (these are solder joints) |  |  | 0 | SMD solder JUMPER |  |  |  |  |  |  |  |  |  |  |  |  |  |  |  |  |  |  |  |  |  |  | 7
86 | 172 | 206 | 0 | 206 |  | SJW | SJW | SJ2, SJ3, SJ4, SJ5, SJ6, SJ7, SJ8, SJ9, SJ10, SJ11, SJ12, SJ13, SJ14, SJ15, SJ16, SJ17, SJ18, SJ19, SJ20, SJ21, SJ22, SJ23, SJ24, SJ25, SJ26, SJ27, SJ28, SJ29, SJ30, SJ31, SJ32, SJ33, SJ34, SJ35, SJ36, SJ37, SJ38, SJ39, SJ40, SJ41, SJ42, SJ43, SJ44, SJ45, SJ46, SJ47, SJ48, SJ49, SJ50, SJ51, SJ52, SJ53, SJ54, SJ55, SJ56, SJ57, SJ58, SJ59, SJ60, SJ61, SJ62, SJ63, SJ64, SJ65, SJ66, SJ67, SJ68, SJ69, SJ70, SJ71, SJ72, SJ73, SJ74, SJ75, SJ76, SJ77, SJ78, SJ79, SJ80, SJ81, SJ82, SJ83, SJ84, SJ85, SJ86, SJ87 | N/A (these are solder joints) |  | 0 | 0 | SMD solder JUMPER |  |  |  |  |  |  |  |  |  |  |  |  |  |  |  |  |  |  |  |  |  |  | 3
3 | 6 | 7 | 3 | 4 | 0.1uF | C_CHIP-0805(2012-METRIC) | CAPC2012X110 | C18, C20, C22 | 80-C0805C104K5RACLR | 1416551 | 0.13 | 0.52 | 0805 Capacitor (35V rated min) |  | Capacitor
4 | 8 | 9 | 4 | 5 | 0.47uF | C_CHIP-0805(2012-METRIC) | CAPC2012X110 | C16, C17, C19, C21 | 810-CGA4J3X7R1H474KS | 22550 | 0.35 | 1.75 | 0805 Capacitor (35V rated min) |  | Capacitor
2 | 4 | 5 | 1 | 4 | 1000pF | C1206C102K1RACAUTO | CAPC3216X110N | C1, C15 | 581-1206GC102K | 406666 | 0.25 | 1 | 1206 Capacitor (35V rated min) | In Stock |  |  |  |  |  | 1000 pF ±10% 100V Ceramic Capacitor X7R 1206 (3216 Metric) |  |  |  |  |  |  | KEMET | C1206C102K1RACAUTO |  |  |  |  | 1206 KEMET |  |  |  |  | None | https://pricing.snapeda.com/search/part/C1206C102K1RACAUTO/?ref=eda
3 | 6 | 7 | 3 | 4 | 100K | R-US_CHIP-0805(2012-METRIC) | RESC2012X65 | R7, R8, R9 | 755-SDR10EZPF1003 | 9455 | 0.32 | 1.28 | Resistor Fixed - ANSI |  | Resistor |  |  |  |  |  |  |  |  |  |  |  |  |  |  |  |  |  |  |  |  |  |  |  |  |  |  |  |  |  | Fixed
4 | 8 | 9 | 2 | 7 | 100nF | C1206C104K5RAC7800 | CAPC3216X88N | C5, C6, C7, C9 | 80-C1206104K5RAC7867 | 118335 | 0.14 | 0.98 | Cap Ceramic 0.1uF 50V X7R 10% SMD 1206 125C Plastic T/R Check availability | In Stock |  |  |  |  |  | 0.1 µF ±10% 50V Ceramic Capacitor X7R 1206 (3216 Metric) |  |  |  |  |  |  | KEMET | C1206C104K5RAC7800 |  |  |  |  | 3216 KEMET |  |  |  |  | None | https://pricing.snapeda.com/search/part/C1206C104K5RAC7800/?ref=eda
2 | 4 | 5 | 2 | 3 | 10k | CRGCQ1206J10K | RESC3115X65N | R1, R11 | 755-SFR18EZPJ103 | 7676 | 0.19 | 0.57 | Fixed Resistor CRGCQ 1206 10K 5% Check availability | In Stock |  | 2-2176344-5 |  |  |  | Fixed Resistor CRGCQ 1206 10K 5% |  |  |  |  |  |  | TE Connectivity | CRGCQ1206J10K |  |  |  |  | 3115 TE Connectivity |  |  |  |  | None | https://pricing.snapeda.com/search/part/CRGCQ1206J10K/?ref=eda
2 | 4 | 5 | 0 | 5 | 10uF | GRM21BC8YA106ME11L | CAPC2012X145N | C13, C14 | 81-GRM21BR61H106KE3L | 423985 | 0.34 | 1.7 | Cap Ceramic 10uF 35V X6S 20% Pad SMD 0805 105C T/R |  |  |  |  |  |  | 0805 10 uF 35 V ±20% Tolerance X6S Multilayer Ceramic Capacitor | 490-10505-2-ND |  |  |  |  |  | Murata | GRM21BC8YA106ME11L |  |  |  |  | 2012 Murata |  |  |  |  |  | https://pricing.snapeda.com/search/part/GRM21BC8YA106ME11L/?ref=eda
2 | 4 | 5 | 1 | 4 | 12pF | C_CHIP-0805(2012-METRIC) | CAPC2012X110 | C24, C25 | 77-VJ0805A120JXAPBC | 14622 | 0.17 | 0.68 | Capacitor – Generic. 5% or better, these are the 32KHz osc caps |  | Capacitor
1 | 2 | 2 | 0 | 2 | 1825910-7 | 1825910-7 | SW_1825910-7 | SW1 | 506-2-1825910-7 | 47230 | 0.14 | 0.28 | Switch Tactile OFF (ON) SPST Round Button PC Pins 0.05A 24VDC 100000Cycles 2.55N Thru-Hole Loose Check availability | In Stock |  | 1825910-7 | Single Pole - Single Throw | 50 mA |  | Switch Tactile OFF (ON) SPST Round Button PC Pins 0.05A 24VDC 100000Cycle 2.55N Thru-Hole Loose Piece |  | Compliant |  |  |  |  | TE Connectivity | 1825910-7 |  |  |  |  | None |  |  |  |  | None | https://pricing.snapeda.com/search/part/1825910-7/?ref=eda
4 | 8 | 9 | 2 | 7 | 1uF | GCM31MR71H105KA55L | CAPC3216X125N | C2, C3, C4, C8 | 187-CL31B105KCHNNNE | 216674 | 0.17 | 1.19 | 1206 Capacitor (35V rated min) | In Stock |  |  |  |  |  | SMD Capacitor X7R(EIA) with Capacitance: 1.0uF Tol. 10%. Rated Voltage: 50Vdc |  |  |  |  |  |  | Murata | GCM31MR71H105KA55L |  |  |  |  | 1206 Murata |  |  |  |  | None | https://pricing.snapeda.com/search/part/GCM31MR71H105KA55L/?ref=eda
1 | 2 | 3 | 1 | 2 | 2.2uF | 1206ZC225MAT2A | CAPC3216X178N | C12 | 963-HMK316AC7225KL | 156018 | 0.46 | 0.92 | CERAMIC CAPACITOR, 2.2UF, 10V, X7R, 20%, 1206, FULL REEL Check availability | In Stock |  |  |  |  |  | 2.2 µF ±20% 10V Ceramic Capacitor X7R 1206 (3216 Metric) |  |  |  |  |  |  | AVX | 1206ZC225MAT2A |  |  |  |  | 3216 AVX |  |  |  |  | None | https://pricing.snapeda.com/search/part/1206ZC225MAT2A/?ref=eda
1 | 2 | 3 | 0 | 3 | 210K | R-US_CHIP-0805(2012-METRIC) | RESC2012X65 | R4 | 652-CR0805FX-2103ELF | 73521 | 0.1 | 0.3 | Resistor Fixed - ANSI |  | Resistor |  |  |  |  |  |  |  |  |  |  |  |  |  |  |  |  |  |  |  |  |  |  |  |  |  |  |  |  |  | Fixed
2 | 4 | 5 | 1 | 4 | 22pF | C1206C220JGGAC7800 | CAPC3216X110N | C10, C11 | 81-GRM31A5C3A220JW1D | 25041 | 0.44 | 1.76 | 8MHz oscillator caps. 5% or better | In Stock |  |  |  |  |  | CAP CER 22PF 2KV NP0 1206 |  |  |  |  |  |  | KEMET | C1206C220JGGAC7800 |  |  |  |  | 3216 KEMET |  |  |  |  | None
1 | 2 | 2 | 2 | 0 | 22uF | 860020672011 | 860020672011 | C23 | 710-860020672011 | 14931 | 0.11 | 0 | 22uF 50V Electrolytic Capacitor Wurth 860020672011
2 | 4 | 5 | 2 | 3 | 33 | CRG0805F33R | RESC2012X65N | R2, R3 | 755-SFR10EZPF33R0 | 9904 | 0.19 | 0.57 | USB termination resistors- 1% or better | In Stock |  | 1623198-1 |  |  |  | Fixed Resistors |  | Compliant with Exemptions |  |  |  |  | TE Connectivity | CRG0805F33R |  |  |  |  | 805 |  |  |  | .125 W | None | https://pricing.snapeda.com/search/part/CRG0805F33R/?ref=eda |  | 33 |  |  |  |  |  | 1% |  |  |  | 150 V
2 | 4 | 5 | 1 | 4 | 330 | 782853331SMD | 78285333 | L1, L2 | 710-782853331 | 8727 | 0.25 | 1 | USB ferrite beads
2 | 4 | 5 | 2 | 3 | 4.7K | R-US_CHIP-0805(2012-METRIC) | RESC2012X65 | R5, R6 | 71-CRCW08054K70FKEAH | 105445 | 0.23 | 0.69 | Resistor Fixed - ANSI |  | Resistor |  |  |  |  |  |  |  |  |  |  |  |  |  |  |  |  |  |  |  |  |  |  |  |  |  |  |  |  |  | Fixed
2 | 4 | 5 | 2 | 3 | 5.1k | RNCP0805FTD20R0 | RESC2012X60N | R12, R13 | 755-SDR10EZPD5101 | 14165 | 0.25 | 0.75 | 0805 5.1k resistors (CC resistors, must be 10% tolerance or better) | In Stock |  |  |  |  |  | 20 Ohms ±1% 0.25W, 1/4W Chip Resistor 0805 (2012 Metric) Anti-Sulfur, Moisture Resistant Thin Film |  |  |  |  |  |  | Stackpole Electronics Inc | RNCP0805FTD20R0 |  |  |  |  | 2012 Stackpole |  |  |  |  | None | https://pricing.snapeda.com/search/part/RNCP0805FTD20R0/?ref=eda
1 | 2 | 3 | 0 | 3 | ABM3B-8.000MHZ-B2-T | ABM3B-8.000MHZ-B2-T | OSC_ABM3B-8.000MHZ-B2-T | Y1 | 815-ABM3B-8.0-B2-T | 171094 | 0.64 | 1.92 | 8MHz ±20ppm Crystal 18pF 200 Ohms 4-SMD, No Lead Check availability Check availability Check availability | In Stock |  |  |  |  |  | 8 MHz ±20ppm Crystal 18pF 200 Ohms 4-SMD, No Lead |  |  |  |  |  |  | Abracon | ABM3B-8.000MHZ-B2-T |  |  |  |  | SMD-4 Abracon LLC |  |  |  |  | None | https://pricing.snapeda.com/search/part/ABM3B-8.000MHZ-B2-T/?ref=eda
1 | 2 | 3 | 1 | 2 | ABS07-32.768KHZ-T | ABS07-32.768KHZ-T | XTAL_ABS07-32.768KHZ-T | Y2 | 815-ABS07-32.768KHZT | 631084 | 0.68 | 1.36 | ABS07 Series 32.768 kHz ±20 ppm 12.5 pF -40 to +85 °C SMT Low Profile Crystal Check availability | In Stock |  |  |  |  |  | 32.768 kHz ±20ppm Crystal 12.5pF 70 kOhms 2-SMD, No Lead |  |  |  |  |  |  | Abracon | ABS07-32.768KHZ-T |  |  |  |  | SMD-2 Abracon LLC |  |  |  |  | None | https://pricing.snapeda.com/search/part/ABS07-32.768KHZ-T/?ref=eda
1 | 2 | 2 | 0 | 2 | AP2115M-3.3TRG1 | AP2115M-3.3TRG1 | SOIC127P600X175-8N | U2 | 621-AP2115M-3.3TRG1 | 7582 | 0.41 | 0.82 | AP2115M-3.3TRG1
153 | 306 | 320 | 2 | 318 | BAS16LT3G | BAS16LT3G | SOT95P240X111-3N | D1, D2, D3, D4, D5, D6, D7, D8, D9, D10, D11, D12, D13, D14, D15, D16, D17, D18, D19, D20, D21, D22, D23, D24, D25, D26, D27, D28, D29, D30, D31, D32, D33, D34, D35, D36, D37, D38, D39, D40, D41, D42, D43, D44, D45, D46, D47, D48, D49, D50, D51, D52, D53, D54, D55, D56, D57, D58, D59, D60, D61, D62, D63, D64, D65, D66, D67, D68, D69, D70, D71, D72, D73, D74, D75, D76, D77, D78, D79, D80, D81, D82, D83, D84, D85, D86, D87, D88, D89, D90, D91, D92, D93, D94, D95, D96, D97, D98, D99, D100, D101, D102, D103, D104, D105, D106, D107, D108, D109, D110, D111, D112, D113, D114, D115, D116, D117, D118, D119, D120, D121, D122, D123, D124, D125, D126, D127, D128, D129, D130, D131, D132, D133, D134, D135, D136, D137, D138, D139, D140, D141, D142, D143, D144, D145, D146, D147, D148, D149, D150, D151, D152, D153 | 863-BAS16LT3G | 9204 | 0.054 | 17.172 | Diode Small Signal Switching 100V 0.2A Automotive 3-Pin SOT-23 T/R Check prices | In Stock |  |  |  |  |  | Diode Standard 100V 200mA (DC) Surface Mount SOT-23-3 (TO-236) |  |  |  |  |  |  | ON Semiconductor | BAS16LT3G |  |  |  |  | SOT-23-3 ON Semiconductor |  |  |  |  | None
153 | 306 | 367 | 0 | 367 | CHERRY-MX-LED | CHERRY-MX-LED | CHERRY-MX-LED | KEY_1, KEY_2, KEY_3, KEY_4, KEY_5, KEY_6, KEY_7, KEY_8, KEY_9, KEY_10, KEY_11, KEY_12, KEY_13, KEY_14, KEY_15, KEY_16, KEY_17, KEY_18, KEY_19, KEY_20, KEY_21, KEY_22, KEY_23, KEY_24, KEY_25, KEY_26, KEY_27, KEY_28, KEY_29, KEY_30, KEY_31, KEY_32, KEY_33, KEY_34, KEY_35, KEY_36, KEY_37, KEY_38, KEY_39, KEY_40, KEY_41, KEY_42, KEY_43, KEY_44, KEY_45, KEY_46, KEY_47, KEY_48, KEY_49, KEY_50, KEY_51, KEY_52, KEY_53, KEY_54, KEY_55, KEY_56, KEY_57, KEY_58, KEY_59, KEY_60, KEY_61, KEY_62, KEY_63, KEY_64, KEY_65, KEY_66, KEY_67, KEY_68, KEY_69, KEY_70, KEY_71, KEY_72, KEY_73, KEY_74, KEY_75, KEY_76, KEY_77, KEY_78, KEY_79, KEY_80, KEY_81, KEY_82, KEY_83, KEY_84, KEY_85, KEY_86, KEY_87, KEY_88, KEY_89, KEY_90, KEY_91, KEY_92, KEY_93, KEY_94, KEY_95, KEY_96, KEY_97, KEY_98, KEY_99, KEY_100, KEY_101, KEY_102, KEY_103, KEY_104, KEY_105, KEY_106, KEY_107, KEY_108, KEY_109, KEY_110, KEY_111, KEY_112, KEY_113, KEY_114, KEY_115, KEY_116, KEY_117, KEY_118, KEY_119, KEY_120, KEY_121, KEY_122, KEY_123, KEY_124, KEY_125, KEY_126, KEY_127, KEY_128, KEY_129, KEY_130, KEY_131, KEY_132, KEY_133, KEY_134, KEY_135, KEY_136, KEY_137, KEY_138, KEY_139, KEY_140, KEY_141, KEY_142, KEY_143, KEY_144, KEY_145, KEY_146, KEY_147, KEY_148, KEY_149, KEY_150, KEY_151, KEY_152, KEY_153 | N/A | N/A | 0 | 0 | Cherry MX series keyswitch with LED
4 | 8 | 9 | 0 | 9 | CHERRY-MX-LED-NOPIN | CHERRY-MX-LED-NOPIN | CHERRY-MX-LED-NOPIN | KEY_30_OFFSET, KEY_31_OFFSET, KEY_32_OFFSET, KEY_33_OFFSET | N/A | N/A | 0 | 0 | Cherry MX series keyswitch with LED, without fixation pins
1 | 2 | 2 | 1 | 1 | GRPB052VWQS-RC | GRPB052VWQS-RC | DEBUG | J2 | 649-221121-00010T4LF |  | 0.91 | 0.91 | CONN HEADER 0.050 (replacement part for GRPB052VWQS-RC) | 10PS | DL | SMD | AU" | In Stock |  |  |  |  |  | Connector Header Surface Mount 10 position 0.050 (1.27mm) |  |  |  |  |  |  | Sullins Connector | GRPB052VWQS-RC |  |  |  |  | None |  |  |  |  | None | https://pricing.snapeda.com/search/part/GRPB052VWQS-RC/?ref=eda
1 | 2 | 3 | 3 | 0 | IS31FL3733B-TQLS4 | IS31FL3733B-TQLS4 | IS31FL3733B-TQLS4 | U3 | N/A (we brought enough) |  |  | 0 | IS31FL3733B
31 | 62 | 74 | 0 | 74 | JUMPER-SMT_2_NC_TRACE_NO-SILK | JUMPER-SMT_2_NC_TRACE_NO-SILK | SMT-JUMPER_2_NC_TRACE_NO-SILK | SJ_MCU_COL1, SJ_MCU_COL2, SJ_MCU_COL3, SJ_MCU_COL4, SJ_MCU_COL5, SJ_MCU_COL6, SJ_MCU_COL7, SJ_MCU_COL8, SJ_MCU_COL9, SJ_MCU_COL10, SJ_MCU_COL11, SJ_MCU_COL12, SJ_MCU_COL13, SJ_MCU_COL14, SJ_MCU_COL15, SJ_MCU_COL16, SJ_MCU_COL17, SJ_MCU_COL18, SJ_MCU_COL19, SJ_MCU_COL20, SJ_MCU_COL21, SJ_MCU_COL22, SJ_MCU_COL23, SJ_MCU_COL24, SJ_MCU_ROW1, SJ_MCU_ROW2, SJ_MCU_ROW3, SJ_MCU_ROW4, SJ_MCU_ROW5, SJ_MCU_ROW6, SJ_MCU_ROW7 | N/A (these are solder joints) |  |  | 0 | Normally closed trace jumper
1 | 2 | 3 | 3 | 0 | MK22FX512VLQ12 | MK22FX512AVLQ12 | LQFP-144_20X20X1.6 | U1 | N/A (we brought enough) |  |  | 0 |  |  |  |  |  |  | ARM Cortex-M4 |  |  |  | 512 |  | MK22FX512AVLQ12 | 120 |  |  |  |  |  |  |  |  | 144 |  |  |  |  |  |  |  |  | 128 |  |  |  |  |  | NXP
8 | 16 | 19 | 3 | 16 | TPB2,54 | TPB2,54 | B2,54 | GND1, GND2, GND3, GND4, SCL, SDA, VDD_3V3, VLDO_5V | N/A (test pads) |  |  | 0 | Test pad |  |  |  |  |  |  |  |  |  |  |  |  |  |  |  |  |  |  |  |  |  |  | 3
1 | 2 | 3 | 0 | 3 | LSM115JE3/TR13 | LSM115JE3/TR13 | LSM115JE3/TR13 | D154 | 494-LSM115JE3/TR13 |  | 0.59 | 1.77 | LSM115JE3/TR13
1 | 2 | 3 | 1 | 2 | USB4105-GF-A | USB4105-GF-A | GCT_USB4105-GF-A | J1 | 640-USB4105-GF-A | 181321 | 0.81 | 1.62 | USB-C (USB TYPE-C) USB 2.0 Receptacle Connector 24 (16+8 Dummy) Position Surface Mount, Right Angle; Through Hole Check availability | In Stock |  |  |  |  |  | USB-C (USB TYPE-C) USB 2.0 Receptacle Connector 24 (16+8 Dummy) Position Surface Mount, Right Angle | Through Hole |  |  |  |  |  |  | GCT | USB4105-GF-A |  |  |  |  | None |  |  |  |  | None | https://pricing.snapeda.com/search/part/USB4105-GF-A/?ref=eda
 |  |  |  |  |  |  |  |  |  |  |  | 45.602
