danieldegrasse/Flexboard/SCHEMATIC.pdf

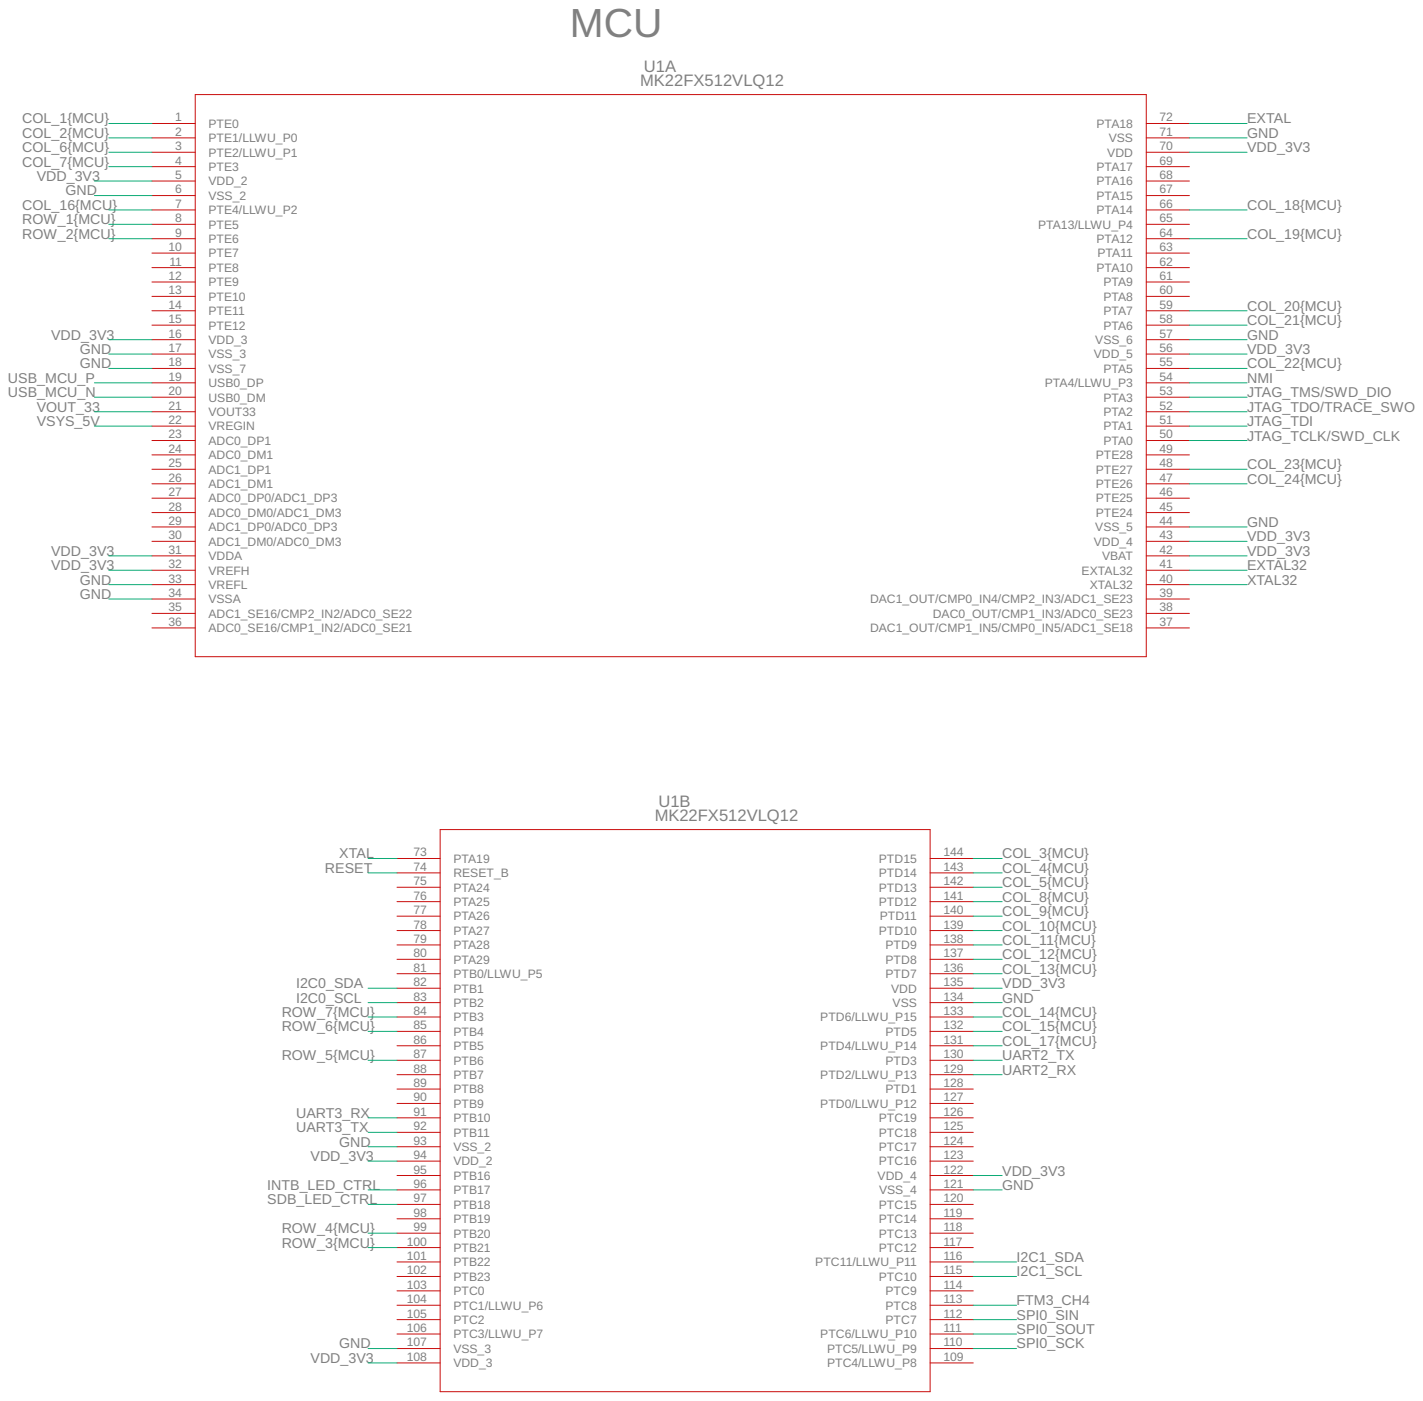
[picture p1: page 1]

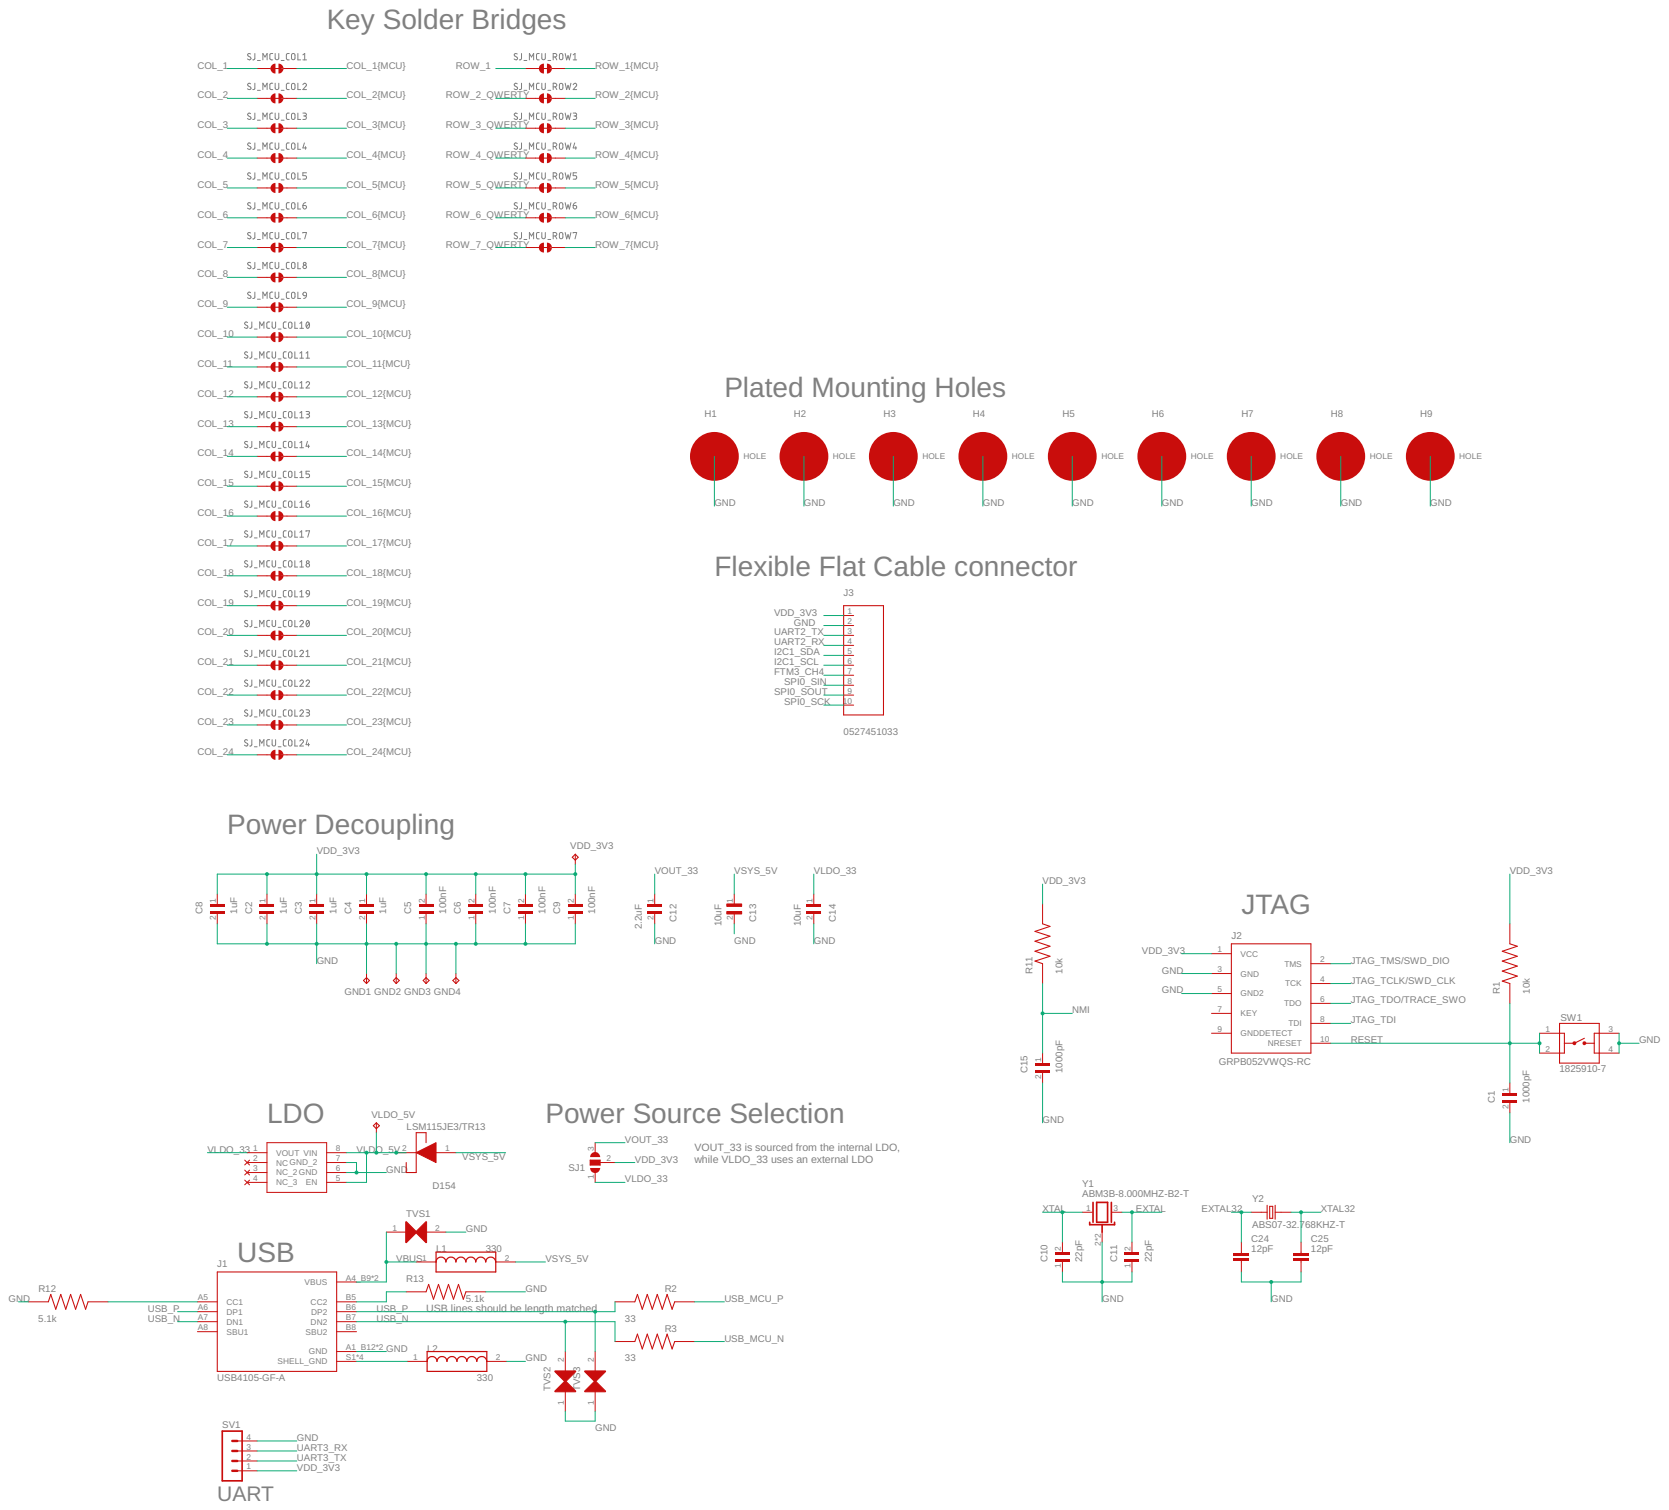
[picture p2: page 2]

ROW_1{MCU} ROW_2{MCU} ROW_3{MCU} ROW_4{MCU} ROW_5{MCU} ROW_6{MCU} ROW_7{MCU}

COL_5{MCU}
COL_8{MCU} COL_9{MCU} COL_10{MCU} COL_11{MCU} COL_12{MCU} COL_13{MCU} COL_14{MCU} COL_15{MCU} COL_17{MCU}

COL_16{MCU}
COL_18{MCU} COL_19{MCU} COL_20{MCU} COL_21{MCU} COL_22{MCU} COL_23{MCU} COL_24{MCU}

Flexible Flat Cable connector

VOUT_33 is sourced from the internal LDO, while VLDO_33 uses an external LDO

USB lines should be length matched

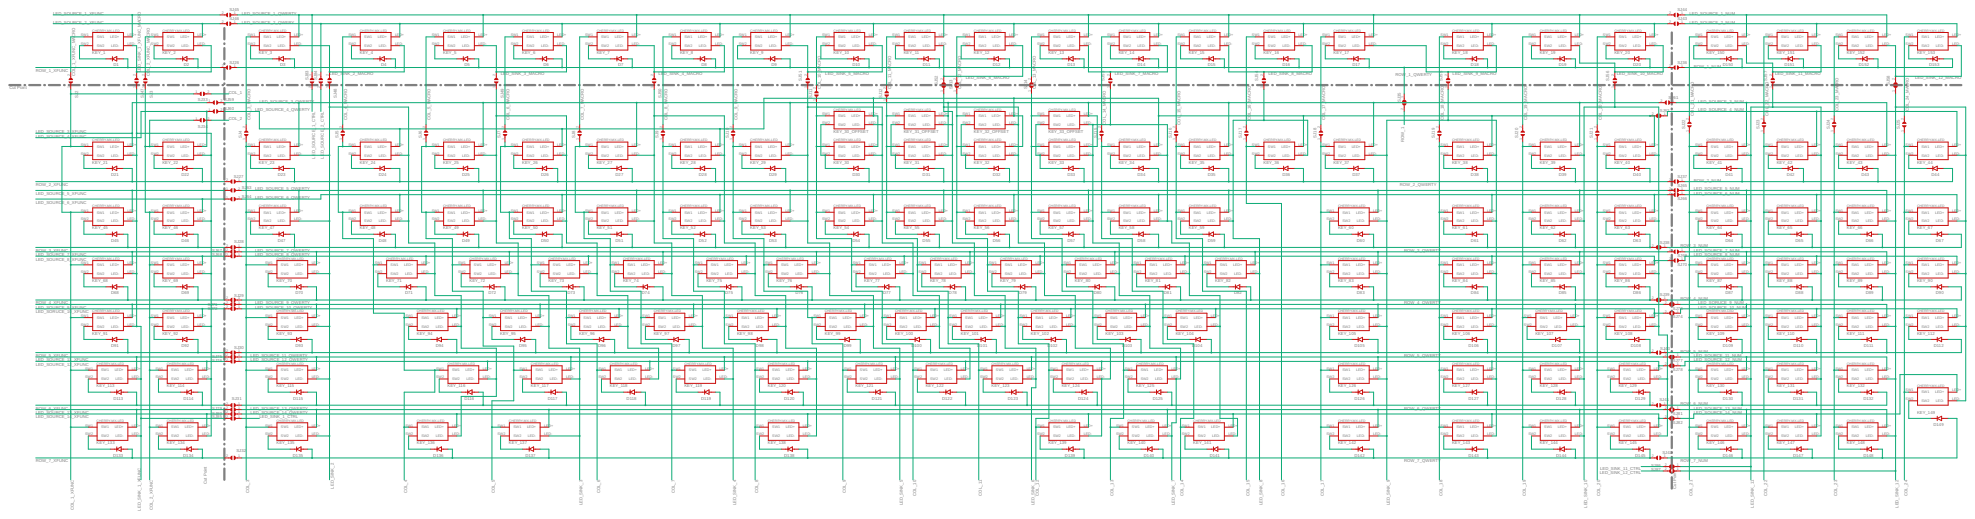
[picture p3: page 3]

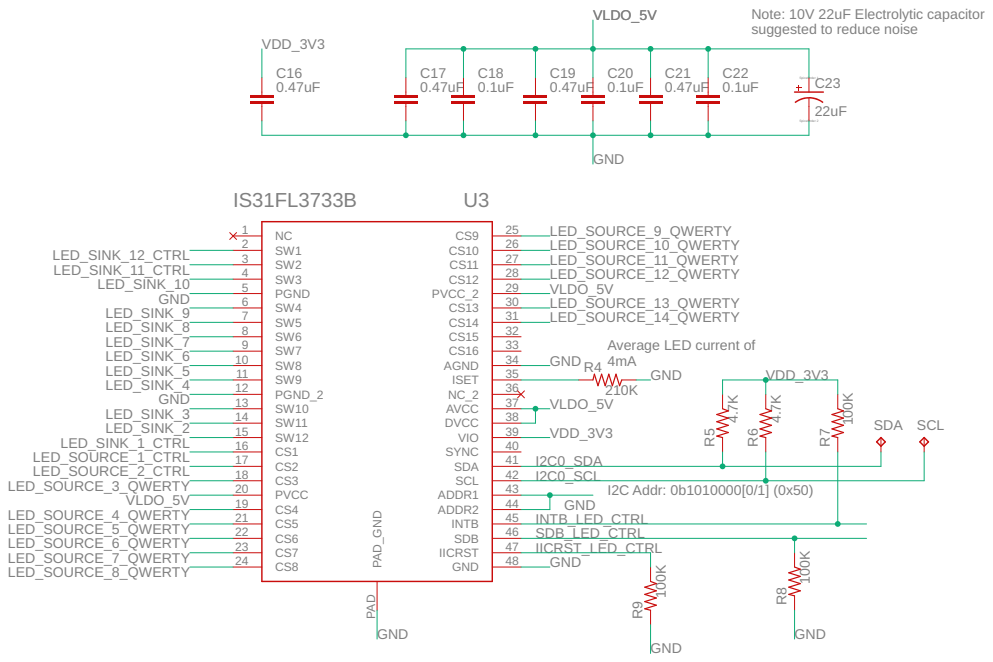
[picture p4: page 4]

Note: 10V 22uF Electrolytic capacitor suggested to reduce noise
