danieldegrasse/Flexboard/LAYOUT.pdf

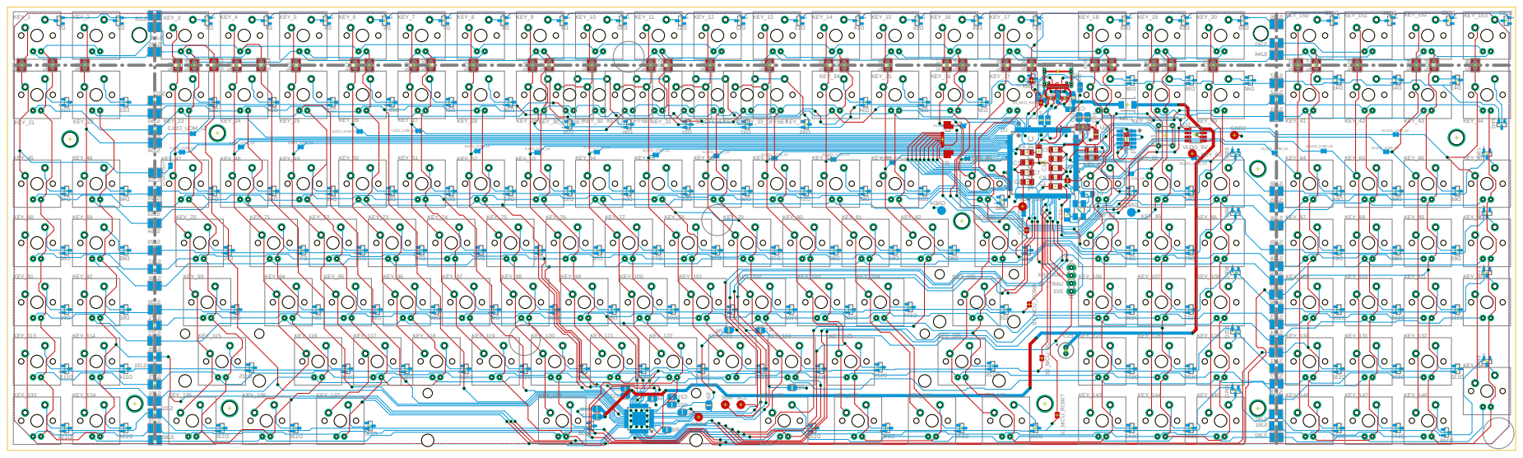
[picture p5: page 1]
