danieldegrasse/Flexboard/Flexboard.brd

## EAGLE design Flexboard.brd (2023-03-07)

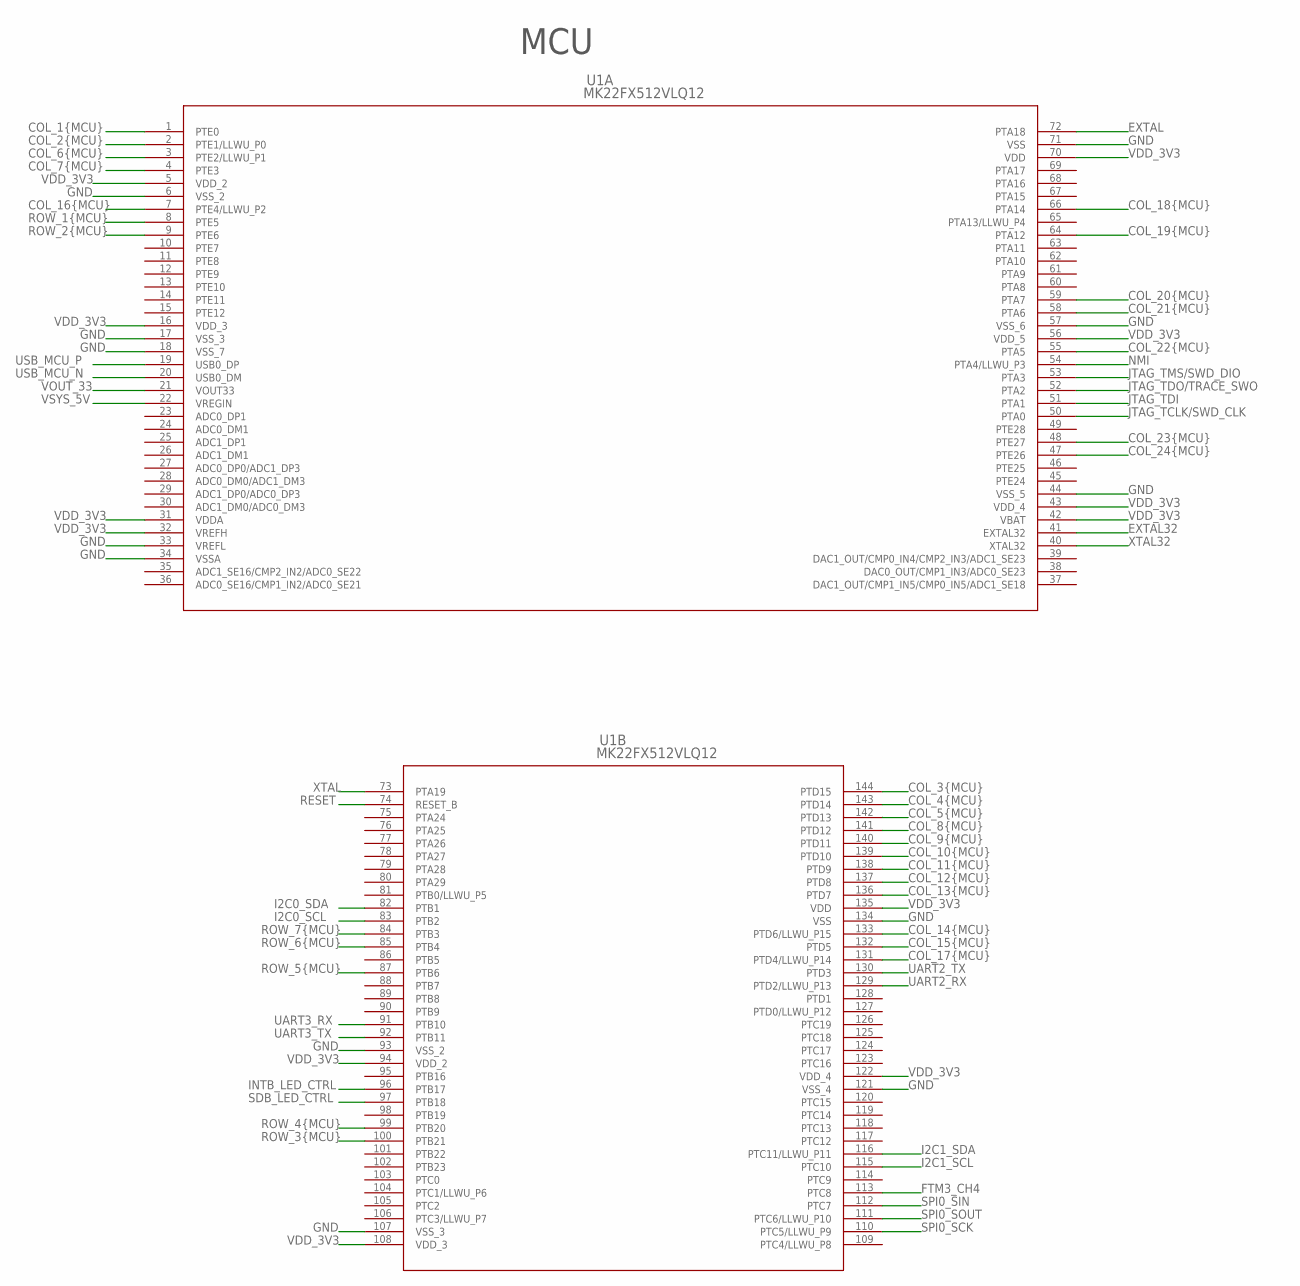
[picture p6: schematic Flexboard.sch, sheet 1, Microcontroller]

Parts:
U1: MK22FX512VLQ12; LQFP-144_20X20X1.6

Connections:
COL_1{MCU}: U1.1 (PTE0); also elsewhere on the board
COL_2{MCU}: U1.2 (PTE1/LLWU_P0); also elsewhere on the board
COL_3{MCU}: U1.144 (PTD15); also elsewhere on the board
COL_4{MCU}: U1.143 (PTD14); also elsewhere on the board
COL_5{MCU}: U1.142 (PTD13); also elsewhere on the board
COL_6{MCU}: U1.3 (PTE2/LLWU_P1); also elsewhere on the board
COL_7{MCU}: U1.4 (PTE3); also elsewhere on the board
COL_8{MCU}: U1.141 (PTD12); also elsewhere on the board
COL_9{MCU}: U1.140 (PTD11); also elsewhere on the board
COL_10{MCU}: U1.139 (PTD10); also elsewhere on the board
COL_11{MCU}: U1.138 (PTD9); also elsewhere on the board
COL_12{MCU}: U1.137 (PTD8); also elsewhere on the board
COL_13{MCU}: U1.136 (PTD7); also elsewhere on the board
COL_14{MCU}: U1.133 (PTD6/LLWU_P15); also elsewhere on the board
COL_15{MCU}: U1.132 (PTD5); also elsewhere on the board
COL_16{MCU}: U1.7 (PTE4/LLWU_P2); also elsewhere on the board
COL_17{MCU}: U1.131 (PTD4/LLWU_P14); also elsewhere on the board
COL_18{MCU}: U1.66 (PTA14); also elsewhere on the board
COL_19{MCU}: U1.64 (PTA12); also elsewhere on the board
COL_20{MCU}: U1.59 (PTA7); also elsewhere on the board
COL_21{MCU}: U1.58 (PTA6); also elsewhere on the board
COL_22{MCU}: U1.55 (PTA5); also elsewhere on the board
COL_23{MCU}: U1.48 (PTE27); also elsewhere on the board
COL_24{MCU}: U1.47 (PTE26); also elsewhere on the board
EXTAL: U1.72 (PTA18); also elsewhere on the board
EXTAL32: U1.41 (EXTAL32); also elsewhere on the board
FTM3_CH4: U1.113 (PTC8); also elsewhere on the board
GND: U1.6 (VSS_2), U1.17 (VSS_3), U1.18 (VSS_7), U1.33 (VREFL), U1.34 (VSSA), U1.44 (VSS_5), U1.57 (VSS_6), U1.71 (VSS), U1.93 (VSS_2), U1.107 (VSS_3), U1.121 (VSS_4), U1.134 (VSS); also elsewhere on the board
I2C0_SCL: U1.83 (PTB2); also elsewhere on the board
I2C0_SDA: U1.82 (PTB1); also elsewhere on the board
I2C1_SCL: U1.115 (PTC10); also elsewhere on the board
I2C1_SDA: U1.116 (PTC11/LLWU_P11); also elsewhere on the board
INTB_LED_CTRL: U1.96 (PTB17); also elsewhere on the board
JTAG_TCLK/SWD_CLK: U1.50 (PTA0); also elsewhere on the board
JTAG_TDI: U1.51 (PTA1); also elsewhere on the board
JTAG_TDO/TRACE_SWO: U1.52 (PTA2); also elsewhere on the board
JTAG_TMS/SWD_DIO: U1.53 (PTA3); also elsewhere on the board
NMI: U1.54 (PTA4/LLWU_P3); also elsewhere on the board
RESET: U1.74 (RESET_B); also elsewhere on the board
ROW_1{MCU}: U1.8 (PTE5); also elsewhere on the board
ROW_2{MCU}: U1.9 (PTE6); also elsewhere on the board
ROW_3{MCU}: U1.100 (PTB21); also elsewhere on the board
ROW_4{MCU}: U1.99 (PTB20); also elsewhere on the board
ROW_5{MCU}: U1.87 (PTB6); also elsewhere on the board
ROW_6{MCU}: U1.85 (PTB4); also elsewhere on the board
ROW_7{MCU}: U1.84 (PTB3); also elsewhere on the board
SDB_LED_CTRL: U1.97 (PTB18); also elsewhere on the board
SPI0_SCK: U1.110 (PTC5/LLWU_P9); also elsewhere on the board
SPI0_SIN: U1.112 (PTC7); also elsewhere on the board
SPI0_SOUT: U1.111 (PTC6/LLWU_P10); also elsewhere on the board
UART2_RX: U1.129 (PTD2/LLWU_P13); also elsewhere on the board
UART2_TX: U1.130 (PTD3); also elsewhere on the board
UART3_RX: U1.91 (PTB10); also elsewhere on the board
UART3_TX: U1.92 (PTB11); also elsewhere on the board
USB_MCU_N: U1.20 (USB0_DM); also elsewhere on the board
USB_MCU_P: U1.19 (USB0_DP); also elsewhere on the board
VDD_3V3: U1.5 (VDD_2), U1.16 (VDD_3), U1.31 (VDDA), U1.32 (VREFH), U1.42 (VBAT), U1.43 (VDD_4), U1.56 (VDD_5), U1.70 (VDD), U1.94 (VDD_2), U1.108 (VDD_3), U1.122 (VDD_4), U1.135 (VDD); also elsewhere on the board
VOUT_33: U1.21 (VOUT33); also elsewhere on the board
VSYS_5V: U1.22 (VREGIN); also elsewhere on the board
XTAL: U1.73 (PTA19); also elsewhere on the board
XTAL32: U1.40 (XTAL32); also elsewhere on the board

Notes on the sheet:
MCU

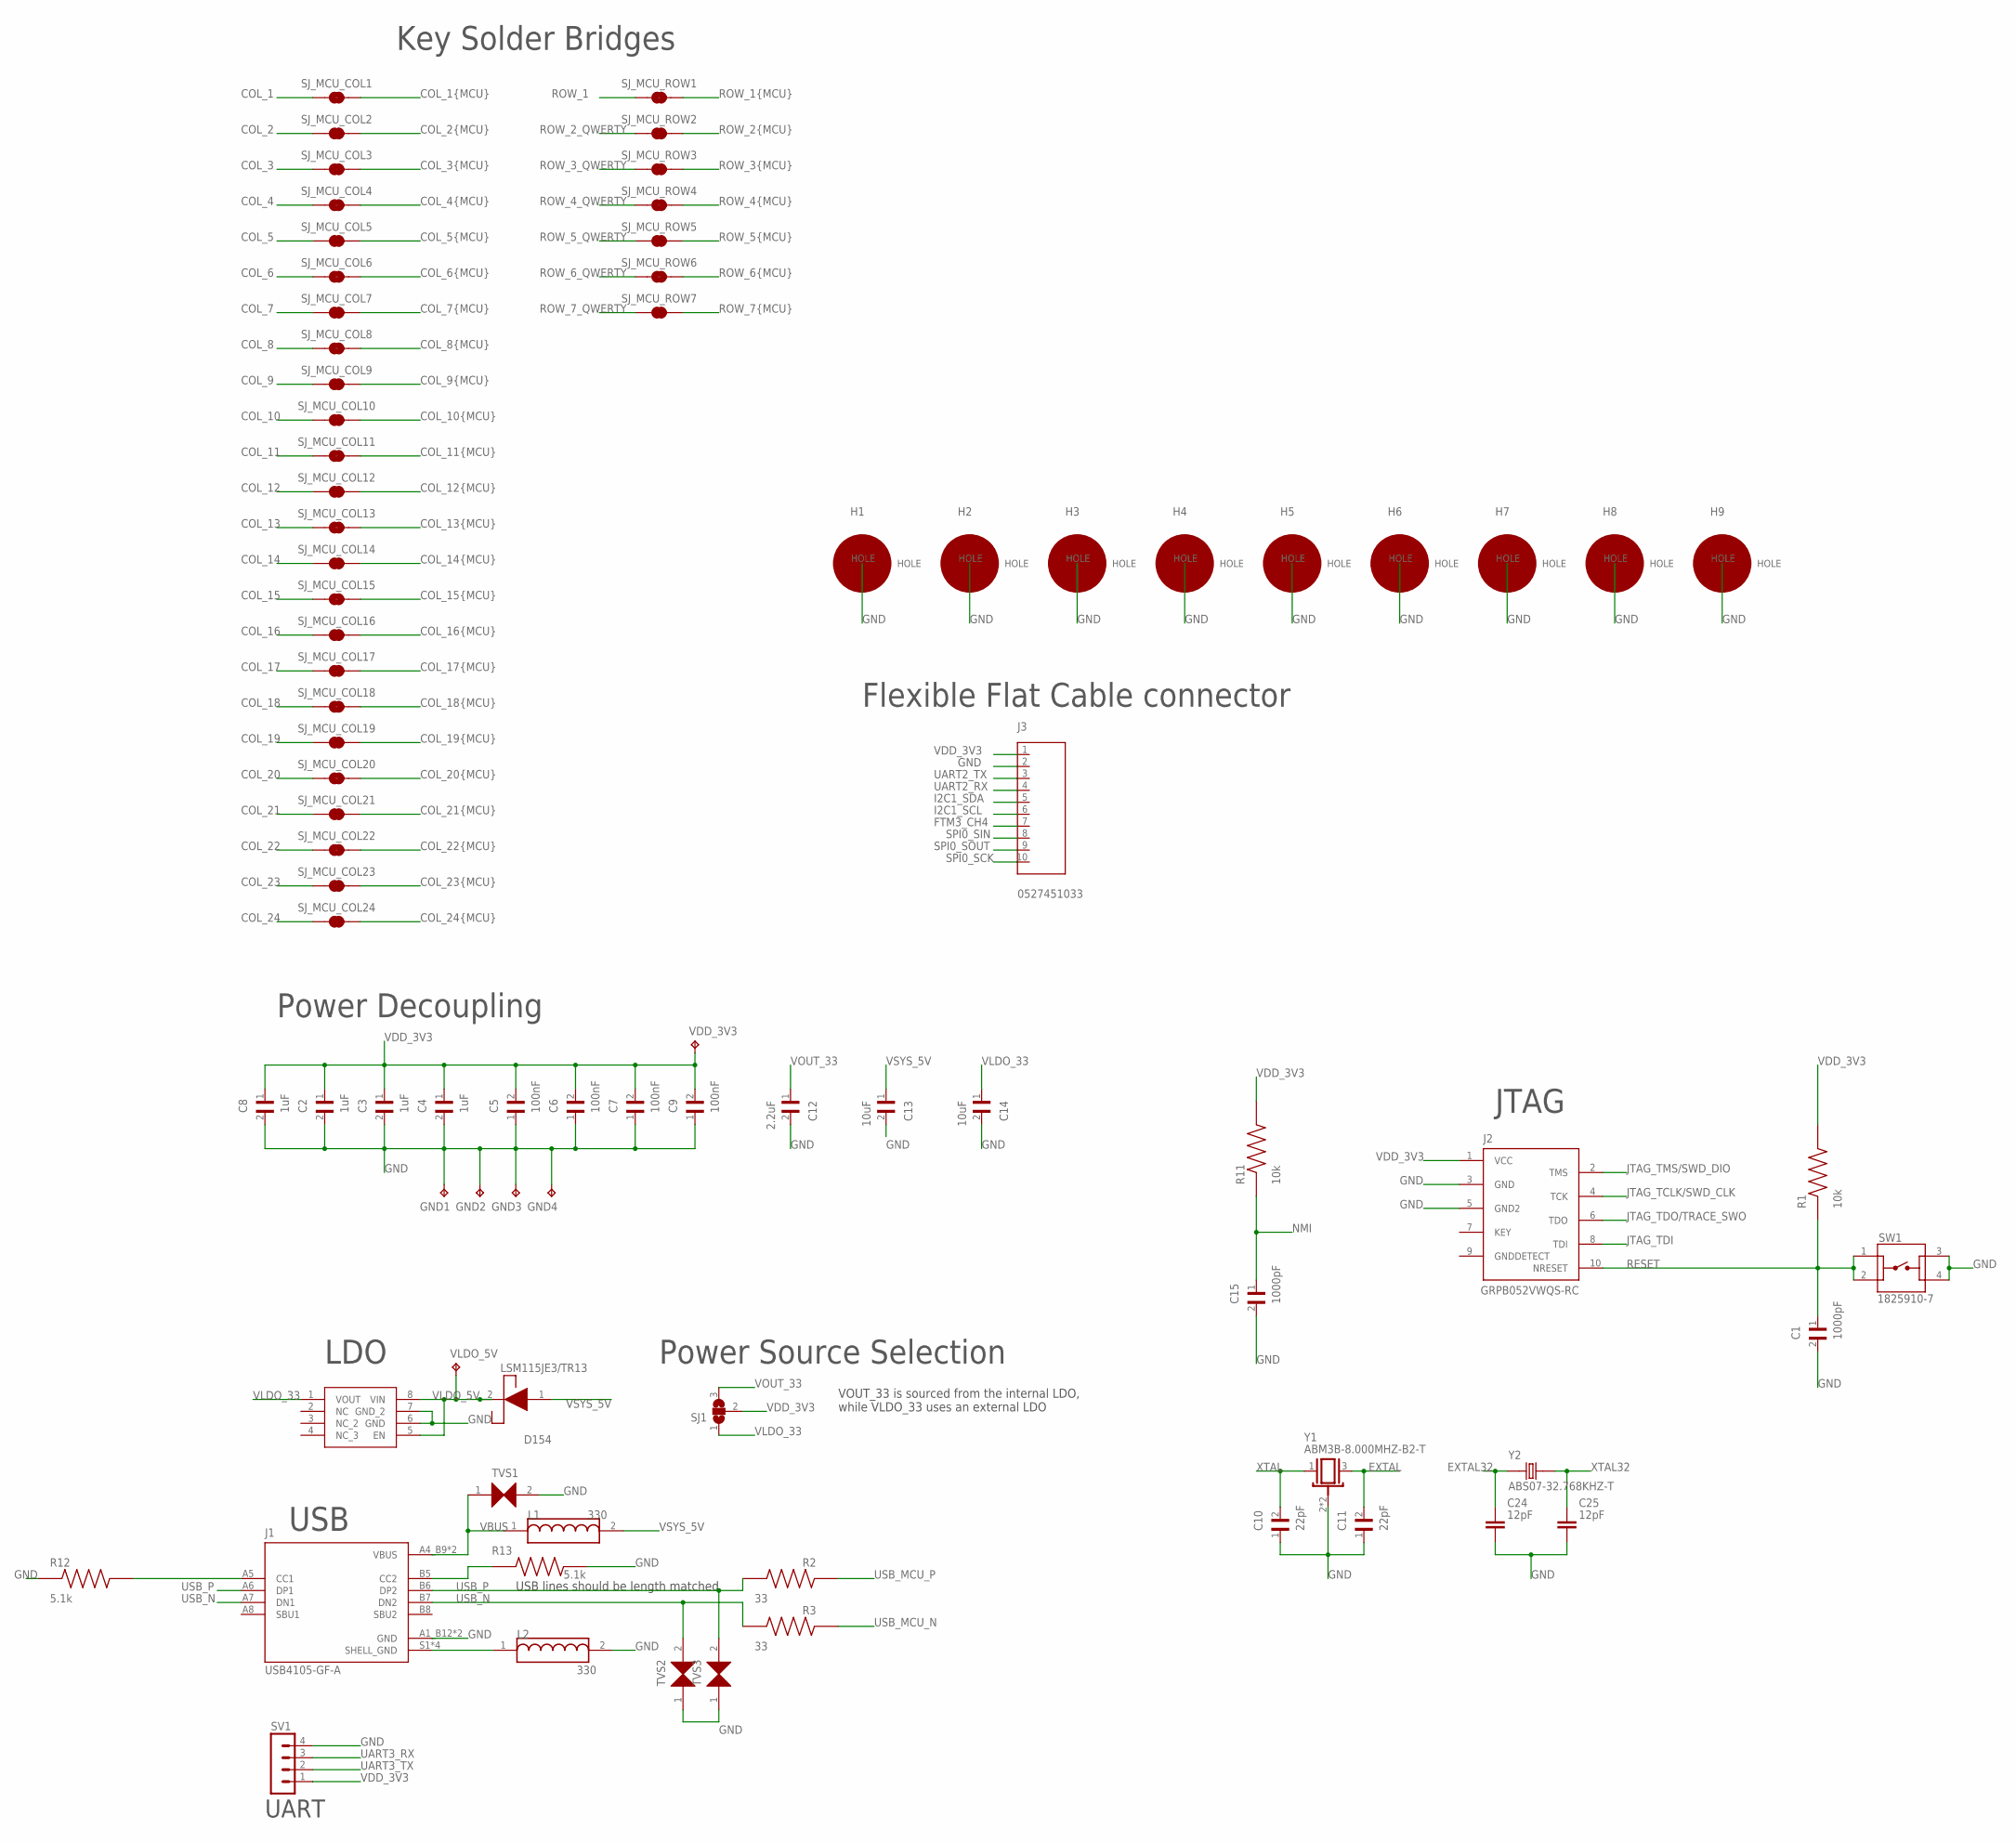
[picture p7: schematic Flexboard.sch, sheet 2, MCU Support]

Parts:
C1, C15: 1000pF; CAPC3216X110N
C2, C3, C4, C8: 1uF; CAPC3216X125N
C5, C6, C7, C9: 100nF; CAPC3216X88N
C10, C11: 22pF; CAPC3216X110N
C12: 2.2uF; CAPC3216X178N
C13, C14: 10uF; CAPC2012X145N
C24, C25: 12pF; CAPC2012X110
D154: LSM115JE3/TR13
GND1, GND2, GND3, GND4: TPB2,54; B2,54
H1, H2, H3, H4, H5, H6, H7, H8, H9: PTH
J1: USB4105-GF-A; GCT_USB4105-GF-A
J2: GRPB052VWQS-RC; DEBUG
J3: 0527451033; 52745-1033
L1, L2: 330; 78285333
R1, R11: 10k; RESC3115X65N
R2, R3: 33; RESC2012X65N
R12, R13: 5.1k; RESC2012X60N
SJ1: SJ2W; SJ_2
SJ_MCU_COL1, SJ_MCU_COL2, SJ_MCU_COL3, SJ_MCU_COL4, SJ_MCU_COL5, SJ_MCU_COL6, SJ_MCU_COL7, SJ_MCU_COL8, SJ_MCU_COL9, SJ_MCU_COL10, SJ_MCU_COL11, SJ_MCU_COL12, SJ_MCU_COL13, SJ_MCU_COL14, SJ_MCU_COL15, SJ_MCU_COL16, SJ_MCU_COL17, SJ_MCU_COL18, SJ_MCU_COL19, SJ_MCU_COL20, SJ_MCU_COL21, SJ_MCU_COL22, SJ_MCU_COL23, SJ_MCU_COL24: JUMPER-SMT_2_NC_TRACE_NO-SILK; SMT-JUMPER_2_NC_TRACE_NO-SILK
SJ_MCU_ROW1, SJ_MCU_ROW2, SJ_MCU_ROW3, SJ_MCU_ROW4, SJ_MCU_ROW5, SJ_MCU_ROW6, SJ_MCU_ROW7: JUMPER-SMT_2_NC_TRACE_NO-SILK; SMT-JUMPER_2_NC_TRACE_NO-SILK
SV1: MA04-1
SW1: 1825910-7; SW_1825910-7
TVS1, TVS2, TVS3: 0603ESDA2-TR2
U2: AP2115M-3.3TRG1; SOIC127P600X175-8N
VDD_3V3: TPB2,54; B2,54
VLDO_5V: TPB2,54; B2,54
Y1: ABM3B-8.000MHZ-B2-T; OSC_ABM3B-8.000MHZ-B2-T
Y2: ABS07-32.768KHZ-T; XTAL_ABS07-32.768KHZ-T

Connections:
COL_1: SJ_MCU_COL1.1; also elsewhere on the board
COL_1{MCU}: SJ_MCU_COL1.2; also elsewhere on the board
COL_2: SJ_MCU_COL2.1; also elsewhere on the board
COL_2{MCU}: SJ_MCU_COL2.2; also elsewhere on the board
COL_3: SJ_MCU_COL3.1; also elsewhere on the board
COL_3{MCU}: SJ_MCU_COL3.2; also elsewhere on the board
COL_4: SJ_MCU_COL4.1; also elsewhere on the board
COL_4{MCU}: SJ_MCU_COL4.2; also elsewhere on the board
COL_5: SJ_MCU_COL5.1; also elsewhere on the board
COL_5{MCU}: SJ_MCU_COL5.2; also elsewhere on the board
COL_6: SJ_MCU_COL6.1; also elsewhere on the board
COL_6{MCU}: SJ_MCU_COL6.2; also elsewhere on the board
COL_7: SJ_MCU_COL7.1; also elsewhere on the board
COL_7{MCU}: SJ_MCU_COL7.2; also elsewhere on the board
COL_8: SJ_MCU_COL8.1; also elsewhere on the board
COL_8{MCU}: SJ_MCU_COL8.2; also elsewhere on the board
COL_9: SJ_MCU_COL9.1; also elsewhere on the board
COL_9{MCU}: SJ_MCU_COL9.2; also elsewhere on the board
COL_10: SJ_MCU_COL10.1; also elsewhere on the board
COL_10{MCU}: SJ_MCU_COL10.2; also elsewhere on the board
COL_11: SJ_MCU_COL11.1; also elsewhere on the board
COL_11{MCU}: SJ_MCU_COL11.2; also elsewhere on the board
COL_12: SJ_MCU_COL12.1; also elsewhere on the board
COL_12{MCU}: SJ_MCU_COL12.2; also elsewhere on the board
COL_13: SJ_MCU_COL13.1; also elsewhere on the board
COL_13{MCU}: SJ_MCU_COL13.2; also elsewhere on the board
COL_14: SJ_MCU_COL14.1; also elsewhere on the board
COL_14{MCU}: SJ_MCU_COL14.2; also elsewhere on the board
COL_15: SJ_MCU_COL15.1; also elsewhere on the board
COL_15{MCU}: SJ_MCU_COL15.2; also elsewhere on the board
COL_16: SJ_MCU_COL16.1; also elsewhere on the board
COL_16{MCU}: SJ_MCU_COL16.2; also elsewhere on the board
COL_17: SJ_MCU_COL17.1; also elsewhere on the board
COL_17{MCU}: SJ_MCU_COL17.2; also elsewhere on the board
COL_18: SJ_MCU_COL18.1; also elsewhere on the board
COL_18{MCU}: SJ_MCU_COL18.2; also elsewhere on the board
COL_19: SJ_MCU_COL19.1; also elsewhere on the board
COL_19{MCU}: SJ_MCU_COL19.2; also elsewhere on the board
COL_20: SJ_MCU_COL20.1; also elsewhere on the board
COL_20{MCU}: SJ_MCU_COL20.2; also elsewhere on the board
COL_21: SJ_MCU_COL21.1; also elsewhere on the board
COL_21{MCU}: SJ_MCU_COL21.2; also elsewhere on the board
COL_22: SJ_MCU_COL22.1; also elsewhere on the board
COL_22{MCU}: SJ_MCU_COL22.2; also elsewhere on the board
COL_23: SJ_MCU_COL23.1; also elsewhere on the board
COL_23{MCU}: SJ_MCU_COL23.2; also elsewhere on the board
COL_24: SJ_MCU_COL24.1; also elsewhere on the board
COL_24{MCU}: SJ_MCU_COL24.2; also elsewhere on the board
EXTAL: C11.2, Y1.3; also elsewhere on the board
EXTAL32: C24.1, Y2.1; also elsewhere on the board
FTM3_CH4: J3.7; also elsewhere on the board
GND: C1.2, C2.2, C3.2, C4.2, C5.1, C6.1, C7.1, C8.2, C9.1, C10.1, C11.1, C12.2, C13.2, C14.2, C15.2, C24.2, C25.2, GND1.TP, GND2.TP, GND3.TP, GND4.TP, H1.HOLE, H2.HOLE, H3.HOLE, H4.HOLE, H5.HOLE, H6.HOLE, H7.HOLE, H8.HOLE, H9.HOLE, J1.A1_B12 (GND), J1.B1_A12 (GND), J2.3 (GND), J2.5 (GND2), J3.2, L2.2, R12.1, R13.2, SV1.4, SW1.3, SW1.4, TVS1.2, TVS2.1, TVS3.1, U2.6 (GND), U2.7 (GND_2), Y1.2 (GND), Y1.4 (GND); also elsewhere on the board
I2C1_SCL: J3.6; also elsewhere on the board
I2C1_SDA: J3.5; also elsewhere on the board
JTAG_TCLK/SWD_CLK: J2.4 (TCK); also elsewhere on the board
JTAG_TDI: J2.8 (TDI); also elsewhere on the board
JTAG_TDO/TRACE_SWO: J2.6 (TDO); also elsewhere on the board
JTAG_TMS/SWD_DIO: J2.2 (TMS); also elsewhere on the board
unnamed: J1.S1 (SHELL_GND), J1.S2 (SHELL_GND), J1.S3 (SHELL_GND), J1.S4 (SHELL_GND), L2.1
unnamed: J1.B5 (CC2), R13.1
unnamed: J1.A5 (CC1), R12.2
NMI: C15.1, R11.1; also elsewhere on the board
RESET: C1.1, J2.10 (NRESET), R1.1, SW1.1, SW1.2; also elsewhere on the board
ROW_1: SJ_MCU_ROW1.1; also elsewhere on the board
ROW_1{MCU}: SJ_MCU_ROW1.2; also elsewhere on the board
ROW_2_QWERTY: SJ_MCU_ROW2.1; also elsewhere on the board
ROW_2{MCU}: SJ_MCU_ROW2.2; also elsewhere on the board
ROW_3_QWERTY: SJ_MCU_ROW3.1; also elsewhere on the board
ROW_3{MCU}: SJ_MCU_ROW3.2; also elsewhere on the board
ROW_4_QWERTY: SJ_MCU_ROW4.1; also elsewhere on the board
ROW_4{MCU}: SJ_MCU_ROW4.2; also elsewhere on the board
ROW_5_QWERTY: SJ_MCU_ROW5.1; also elsewhere on the board
ROW_5{MCU}: SJ_MCU_ROW5.2; also elsewhere on the board
ROW_6_QWERTY: SJ_MCU_ROW6.1; also elsewhere on the board
ROW_6{MCU}: SJ_MCU_ROW6.2; also elsewhere on the board
ROW_7_QWERTY: SJ_MCU_ROW7.1; also elsewhere on the board
ROW_7{MCU}: SJ_MCU_ROW7.2; also elsewhere on the board
SPI0_SCK: J3.10; also elsewhere on the board
SPI0_SIN: J3.8; also elsewhere on the board
SPI0_SOUT: J3.9; also elsewhere on the board
UART2_RX: J3.4; also elsewhere on the board
UART2_TX: J3.3; also elsewhere on the board
UART3_RX: SV1.3; also elsewhere on the board
UART3_TX: SV1.2; also elsewhere on the board
USB_MCU_N: R3.2; also elsewhere on the board
USB_MCU_P: R2.2; also elsewhere on the board
USB_N: J1.A7 (DN1), J1.B7 (DN2), R3.1, TVS2.2
USB_P: J1.A6 (DP1), J1.B6 (DP2), R2.1, TVS3.2
VBUS: J1.A4_B9 (VBUS), J1.B4_A9 (VBUS), L1.1, TVS1.1
VDD_3V3: C2.1, C3.1, C4.1, C5.2, C6.2, C7.2, C8.1, C9.2, J2.1 (VCC), J3.1, R1.2, R11.2, SJ1.2, SV1.1, VDD_3V3.TP; also elsewhere on the board
VLDO_5V: D154.2 (CATHODE), U2.5 (EN), U2.8 (VIN), VLDO_5V.TP; also elsewhere on the board
VLDO_33: C14.1, SJ1.1, U2.1 (VOUT)
VOUT_33: C12.1, SJ1.3; also elsewhere on the board
VSYS_5V: C13.1, D154.1 (ANODE), L1.2; also elsewhere on the board
XTAL: C10.2, Y1.1; also elsewhere on the board
XTAL32: C25.1, Y2.2; also elsewhere on the board

Notes on the sheet:
USB
Key Solder Bridges
JTAG
UART
Power Source Selection
Power Decoupling
LDO
VOUT_33 is sourced from the internal LDO, while VLDO_33 uses an external LDO
USB lines should be length matched
Flexible Flat Cable connector
