danieldegrasse/Flexboard/Flexboard.brd

## EAGLE design Flexboard.brd (continued)

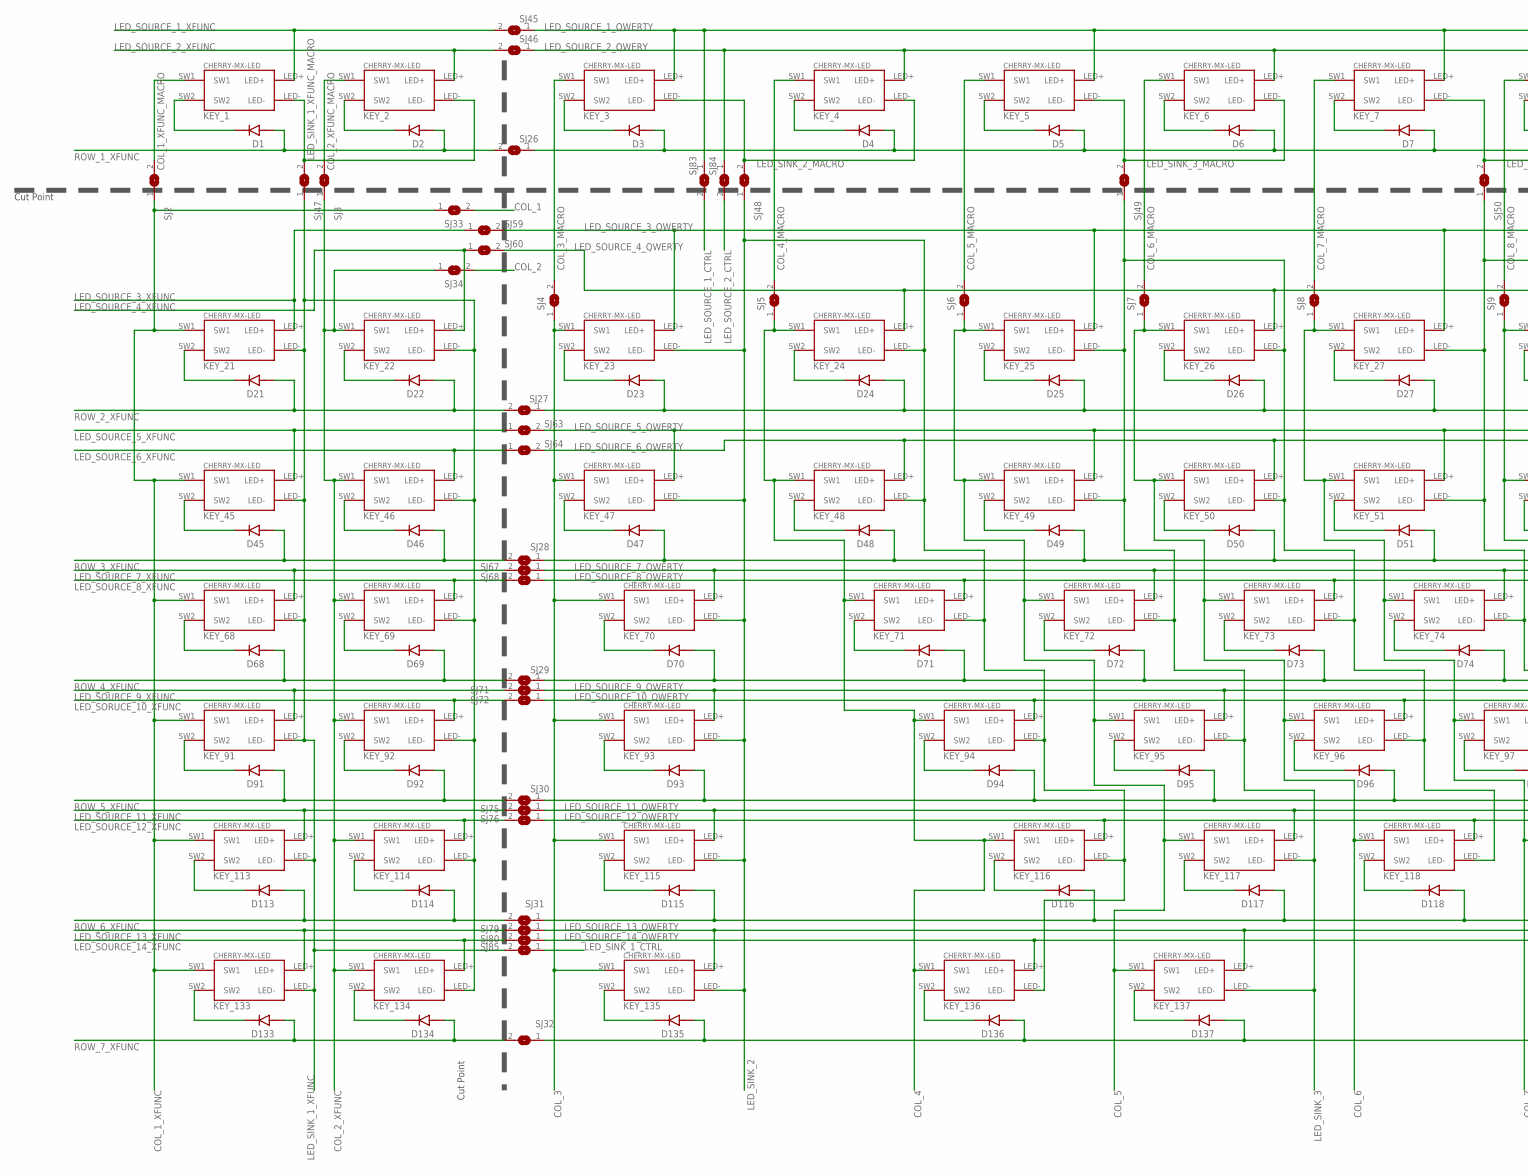
[picture p8: schematic Flexboard.sch, sheet 3, Key matrix, part in row 1, column 1]

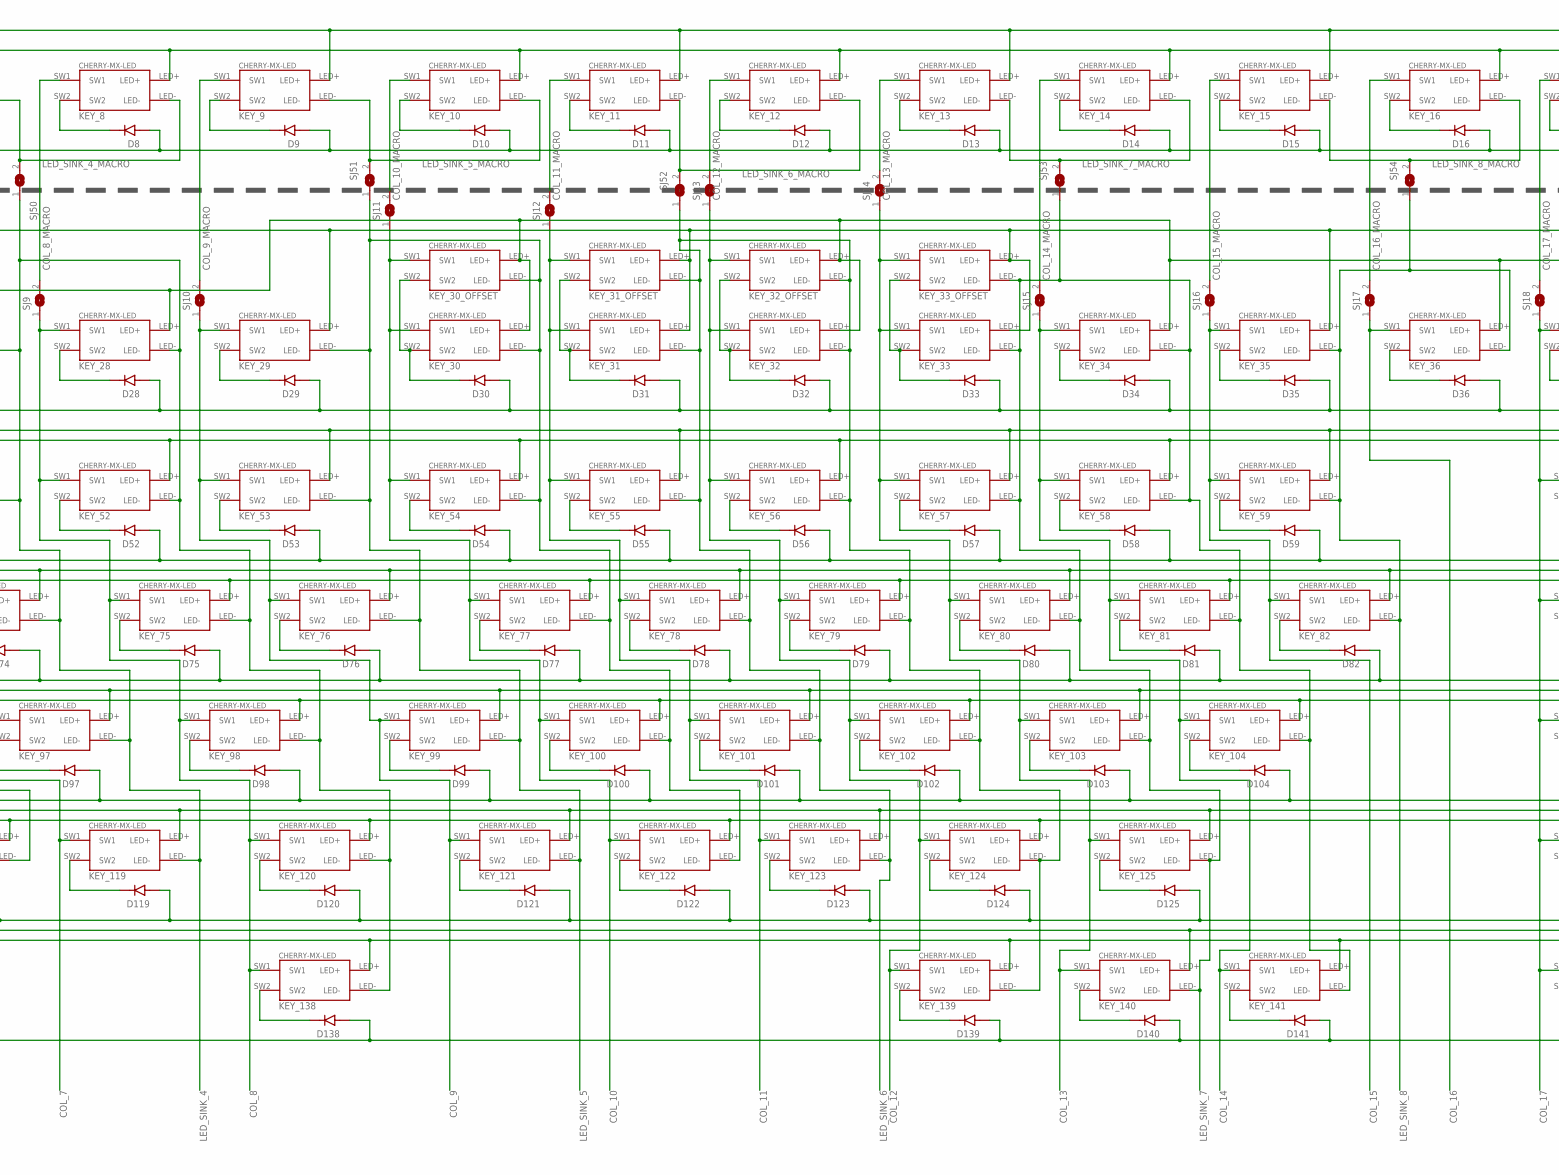
[picture p9: schematic Flexboard.sch, sheet 3, Key matrix, part in row 1, column 2]

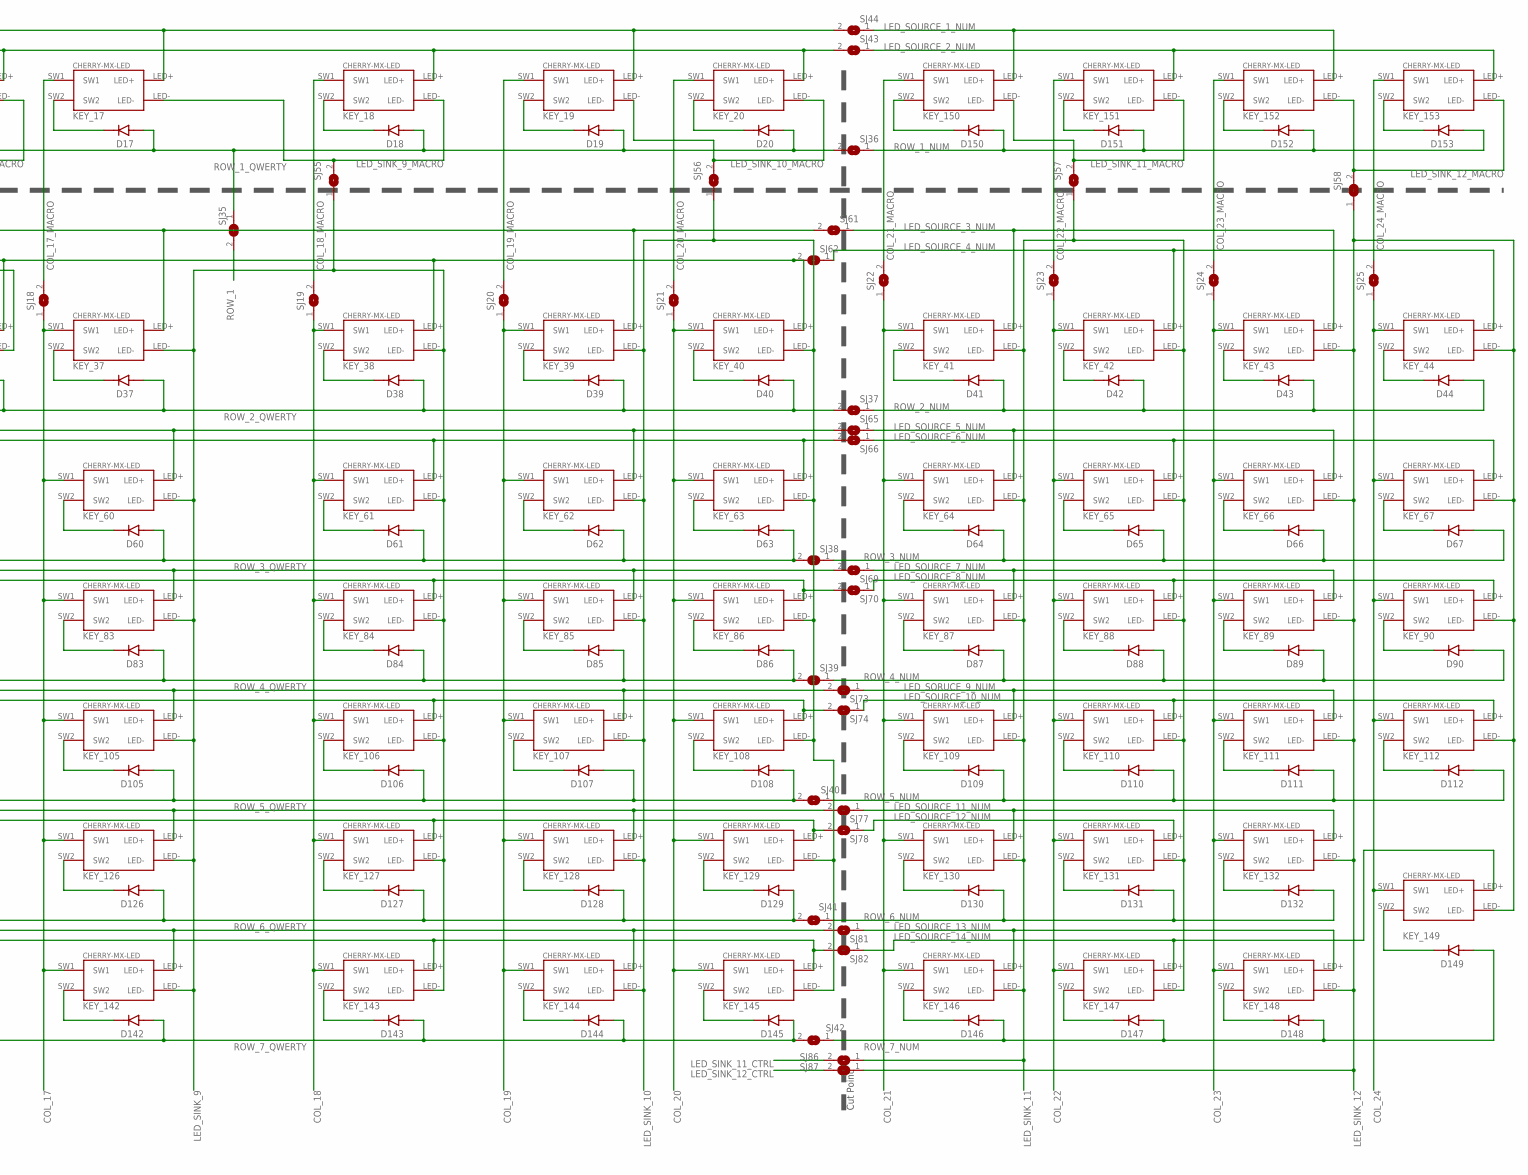
[picture p10: schematic Flexboard.sch, sheet 3, Key matrix, part in row 1, column 3]

Parts:
D1, D2, D3, D4, D5, D6, D7, D8, D9, D10, D11, D12, D13, D14, D15, D16, D17, D18, D19, D20, D21, D22, D23, D24, D25, D26, D27, D28, D29, D30, D31, D32, D33, D34, D35, D36, D37, D38, D39, D40, D41, D42, D43, D44, D45, D46, D47, D48, D49, D50, D51, D52, D53, D54, D55, D56, D57, D58, D59, D60, D61, D62, D63, D64, D65, D66, D67, D68, D69, D70, D71, D72, D73, D74, D75, D76, D77, D78, D79, D80, D81, D82, D83, D84, D85, D86, D87, D88, D89, D90, D91, D92, D93, D94, D95, D96, D97, D98, D99, D100, D101, D102, D103, D104, D105, D106, D107, D108, D109, D110, D111, D112, D113, D114, D115, D116, D117, D118, D119, D120, D121, D122, D123, D124, D125, D126, D127, D128, D129, D130, D131, D132, D133, D134, D135, D136, D137, D138, D139, D140, D141, D142, D143, D144, D145, D146, D147, D148, D149, D150, D151, D152, D153: BAS16LT3G; SOT95P240X111-3N
KEY_1, KEY_2, KEY_3, KEY_4, KEY_5, KEY_6, KEY_7, KEY_8, KEY_9, KEY_10, KEY_11, KEY_12, KEY_13, KEY_14, KEY_15, KEY_16, KEY_17, KEY_18, KEY_19, KEY_20, KEY_21, KEY_22, KEY_23, KEY_24, KEY_25, KEY_26, KEY_27, KEY_28, KEY_29, KEY_30, KEY_31, KEY_32, KEY_33, KEY_34, KEY_35, KEY_36, KEY_37, KEY_38, KEY_39, KEY_40, KEY_41, KEY_42, KEY_43, KEY_44, KEY_45, KEY_46, KEY_47, KEY_48, KEY_49, KEY_50, KEY_51, KEY_52, KEY_53, KEY_54, KEY_55, KEY_56, KEY_57, KEY_58, KEY_59, KEY_60, KEY_61, KEY_62, KEY_63, KEY_64, KEY_65, KEY_66, KEY_67, KEY_68, KEY_69, KEY_70, KEY_71, KEY_72, KEY_73, KEY_74, KEY_75, KEY_76, KEY_77, KEY_78, KEY_79, KEY_80, KEY_81, KEY_82, KEY_83, KEY_84, KEY_85, KEY_86, KEY_87, KEY_88, KEY_89, KEY_90, KEY_91, KEY_92, KEY_93, KEY_94, KEY_95, KEY_96, KEY_97, KEY_98, KEY_99, KEY_100, KEY_101, KEY_102, KEY_103, KEY_104, KEY_105, KEY_106, KEY_107, KEY_108, KEY_109, KEY_110, KEY_111, KEY_112, KEY_113, KEY_114, KEY_115, KEY_116, KEY_117, KEY_118, KEY_119, KEY_120, KEY_121, KEY_122, KEY_123, KEY_124, KEY_125, KEY_126, KEY_127, KEY_128, KEY_129, KEY_130, KEY_131, KEY_132, KEY_133, KEY_134, KEY_135, KEY_136, KEY_137, KEY_138, KEY_139, KEY_140, KEY_141, KEY_142, KEY_143, KEY_144, KEY_145, KEY_146, KEY_147, KEY_148, KEY_149, KEY_150, KEY_151, KEY_152, KEY_153: CHERRY-MX-LED
KEY_30_OFFSET, KEY_31_OFFSET, KEY_32_OFFSET, KEY_33_OFFSET: CHERRY-MX-LED-NOPIN
SJ2, SJ3, SJ4, SJ5, SJ6, SJ7, SJ8, SJ9, SJ10, SJ11, SJ12, SJ13, SJ14, SJ15, SJ16, SJ17, SJ18, SJ19, SJ20, SJ21, SJ22, SJ23, SJ24, SJ25, SJ26, SJ27, SJ28, SJ29, SJ30, SJ31, SJ32, SJ33, SJ34, SJ35, SJ36, SJ37, SJ38, SJ39, SJ40, SJ41, SJ42, SJ43, SJ44, SJ45, SJ46, SJ47, SJ48, SJ49, SJ50, SJ51, SJ52, SJ53, SJ54, SJ55, SJ56, SJ57, SJ58, SJ59, SJ60, SJ61, SJ62, SJ63, SJ64, SJ65, SJ66, SJ67, SJ68, SJ69, SJ70, SJ71, SJ72, SJ73, SJ74, SJ75, SJ76, SJ77, SJ78, SJ79, SJ80, SJ81, SJ82, SJ83, SJ84, SJ85, SJ86, SJ87: SJW

Connections:
COL_1: SJ33.2; also elsewhere on the board
COL_1_XFUNC: KEY_21.SW1, KEY_45.SW1, KEY_68.SW1, KEY_91.SW1, KEY_113.SW1, KEY_133.SW1, SJ2.1, SJ33.1
COL_1_XFUNC_MACRO: KEY_1.SW1, SJ2.2
COL_2: SJ34.2; also elsewhere on the board
COL_2_XFUNC: KEY_22.SW1, KEY_46.SW1, KEY_69.SW1, KEY_92.SW1, KEY_114.SW1, KEY_134.SW1, SJ3.1, SJ34.1
COL_2_XFUNC_MACRO: KEY_2.SW1, SJ3.2
COL_3: KEY_23.SW1, KEY_47.SW1, KEY_70.SW1, KEY_93.SW1, KEY_115.SW1, KEY_135.SW1, SJ4.1; also elsewhere on the board
COL_3_MACRO: KEY_3.SW1, SJ4.2
COL_4: KEY_24.SW1, KEY_48.SW1, KEY_71.SW1, KEY_94.SW1, KEY_116.SW1, KEY_136.SW1, SJ5.1; also elsewhere on the board
COL_4_MACRO: KEY_4.SW1, SJ5.2
COL_5: KEY_25.SW1, KEY_49.SW1, KEY_72.SW1, KEY_95.SW1, KEY_117.SW1, KEY_137.SW1, SJ6.1; also elsewhere on the board
COL_5_MACRO: KEY_5.SW1, SJ6.2
COL_6: KEY_26.SW1, KEY_50.SW1, KEY_73.SW1, KEY_96.SW1, KEY_118.SW1, SJ7.1; also elsewhere on the board
COL_6_MACRO: KEY_6.SW1, SJ7.2
COL_7: KEY_27.SW1, KEY_51.SW1, KEY_74.SW1, KEY_97.SW1, KEY_119.SW1, SJ8.1; also elsewhere on the board
COL_7_MACRO: KEY_7.SW1, SJ8.2
COL_8: KEY_28.SW1, KEY_52.SW1, KEY_75.SW1, KEY_98.SW1, KEY_120.SW1, KEY_138.SW1, SJ9.1; also elsewhere on the board
COL_8_MACRO: KEY_8.SW1, SJ9.2
COL_9: KEY_29.SW1, KEY_53.SW1, KEY_76.SW1, KEY_99.SW1, KEY_121.SW1, SJ10.1; also elsewhere on the board
COL_9_MACRO: KEY_9.SW1, SJ10.2
COL_10: KEY_30.SW1, KEY_30_OFFSET.SW1, KEY_54.SW1, KEY_77.SW1, KEY_100.SW1, KEY_122.SW1, SJ11.1; also elsewhere on the board
COL_10_MACRO: KEY_10.SW1, SJ11.2
COL_11: KEY_31.SW1, KEY_31_OFFSET.SW1, KEY_55.SW1, KEY_78.SW1, KEY_101.SW1, KEY_123.SW1, SJ12.1; also elsewhere on the board
COL_11_MACRO: KEY_11.SW1, SJ12.2
COL_12: KEY_32.SW1, KEY_32_OFFSET.SW1, KEY_56.SW1, KEY_79.SW1, KEY_102.SW1, KEY_124.SW1, KEY_139.SW1, SJ13.1; also elsewhere on the board
COL_12_MACRO: KEY_12.SW1, SJ13.2
COL_13: KEY_33.SW1, KEY_33_OFFSET.SW1, KEY_57.SW1, KEY_80.SW1, KEY_103.SW1, KEY_125.SW1, KEY_140.SW1, SJ14.1; also elsewhere on the board
COL_13_MACRO: KEY_13.SW1, SJ14.2
COL_14: KEY_34.SW1, KEY_58.SW1, KEY_81.SW1, KEY_104.SW1, KEY_141.SW1, SJ15.1; also elsewhere on the board
COL_14_MACRO: KEY_14.SW1, SJ15.2
COL_15: KEY_35.SW1, KEY_59.SW1, KEY_82.SW1, SJ16.1; also elsewhere on the board
COL_15_MACRO: KEY_15.SW1, SJ16.2
COL_16: KEY_36.SW1, SJ17.1; also elsewhere on the board
COL_16_MACRO: KEY_16.SW1, SJ17.2
COL_17: KEY_37.SW1, KEY_60.SW1, KEY_83.SW1, KEY_105.SW1, KEY_126.SW1, KEY_142.SW1, SJ18.1; also elsewhere on the board
COL_17_MACRO: KEY_17.SW1, SJ18.2
COL_18: KEY_38.SW1, KEY_61.SW1, KEY_84.SW1, KEY_106.SW1, KEY_127.SW1, KEY_143.SW1, SJ19.1; also elsewhere on the board
COL_18_MACRO: KEY_18.SW1, SJ19.2
COL_19: KEY_39.SW1, KEY_62.SW1, KEY_85.SW1, KEY_107.SW1, KEY_128.SW1, KEY_144.SW1, SJ20.1; also elsewhere on the board
COL_19_MACRO: KEY_19.SW1, SJ20.2
COL_20: KEY_40.SW1, KEY_63.SW1, KEY_86.SW1, KEY_108.SW1, KEY_129.SW1, KEY_145.SW1, SJ21.1; also elsewhere on the board
COL_20_MACRO: KEY_20.SW1, SJ21.2
COL_21: KEY_41.SW1, KEY_64.SW1, KEY_87.SW1, KEY_109.SW1, KEY_130.SW1, KEY_146.SW1, SJ22.1; also elsewhere on the board
COL_21_MACRO: KEY_150.SW1, SJ22.2
COL_22: KEY_42.SW1, KEY_65.SW1, KEY_88.SW1, KEY_110.SW1, KEY_131.SW1, KEY_147.SW1, SJ23.1; also elsewhere on the board
COL_22_MACRO: KEY_151.SW1, SJ23.2
COL_23: KEY_43.SW1, KEY_66.SW1, KEY_89.SW1, KEY_111.SW1, KEY_132.SW1, KEY_148.SW1, SJ24.1; also elsewhere on the board
COL_23_MACRO: KEY_152.SW1, SJ24.2
COL_24: KEY_44.SW1, KEY_67.SW1, KEY_90.SW1, KEY_112.SW1, KEY_149.SW1, SJ25.1; also elsewhere on the board
COL_24_MACRO: KEY_153.SW1, SJ25.2
LED_SINK_1_CTRL: SJ85.1; also elsewhere on the board
LED_SINK_1_XFUNC: KEY_21.LED-, KEY_22.LED-, KEY_45.LED-, KEY_46.LED-, KEY_68.LED-, KEY_69.LED-, KEY_91.LED-, KEY_92.LED-, KEY_113.LED-, KEY_114.LED-, KEY_133.LED-, KEY_134.LED-, SJ47.1, SJ85.2
LED_SINK_1_XFUNC_MACRO: KEY_1.LED-, KEY_2.LED-, SJ47.2
LED_SINK_2: KEY_23.LED-, KEY_24.LED-, KEY_47.LED-, KEY_48.LED-, KEY_70.LED-, KEY_71.LED-, KEY_93.LED-, KEY_94.LED-, KEY_115.LED-, KEY_116.LED-, KEY_135.LED-, KEY_136.LED-, SJ48.1; also elsewhere on the board
LED_SINK_2_MACRO: KEY_3.LED-, KEY_4.LED-, SJ48.2
LED_SINK_3: KEY_25.LED-, KEY_26.LED-, KEY_49.LED-, KEY_50.LED-, KEY_72.LED-, KEY_73.LED-, KEY_95.LED-, KEY_96.LED-, KEY_117.LED-, KEY_118.LED-, KEY_137.LED-, SJ49.1; also elsewhere on the board
LED_SINK_3_MACRO: KEY_5.LED-, KEY_6.LED-, SJ49.2
LED_SINK_4: KEY_27.LED-, KEY_28.LED-, KEY_51.LED-, KEY_52.LED-, KEY_74.LED-, KEY_75.LED-, KEY_97.LED-, KEY_98.LED-, KEY_119.LED-, KEY_120.LED-, KEY_138.LED-, SJ50.1; also elsewhere on the board
LED_SINK_4_MACRO: KEY_7.LED-, KEY_8.LED-, SJ50.2
LED_SINK_5: KEY_29.LED-, KEY_30.LED-, KEY_30_OFFSET.LED-, KEY_53.LED-, KEY_54.LED-, KEY_76.LED-, KEY_77.LED-, KEY_99.LED-, KEY_100.LED-, KEY_121.LED-, KEY_122.LED-, SJ51.1; also elsewhere on the board
LED_SINK_5_MACRO: KEY_9.LED-, KEY_10.LED-, SJ51.2
LED_SINK_6: KEY_31.LED-, KEY_31_OFFSET.LED-, KEY_32.LED-, KEY_32_OFFSET.LED-, KEY_55.LED-, KEY_56.LED-, KEY_78.LED-, KEY_79.LED-, KEY_101.LED-, KEY_102.LED-, KEY_123.LED-, KEY_124.LED-, KEY_139.LED-, SJ52.1; also elsewhere on the board
LED_SINK_6_MACRO: KEY_11.LED-, KEY_12.LED-, SJ52.2
LED_SINK_7: KEY_33.LED-, KEY_33_OFFSET.LED-, KEY_34.LED-, KEY_57.LED-, KEY_58.LED-, KEY_80.LED-, KEY_81.LED-, KEY_103.LED-, KEY_104.LED-, KEY_125.LED-, KEY_140.LED-, KEY_141.LED-, SJ53.1; also elsewhere on the board
LED_SINK_7_MACRO: KEY_13.LED-, KEY_14.LED-, SJ53.2
LED_SINK_8: KEY_35.LED-, KEY_36.LED-, KEY_59.LED-, KEY_82.LED-, SJ54.1; also elsewhere on the board
LED_SINK_8_MACRO: KEY_15.LED-, KEY_16.LED-, SJ54.2
LED_SINK_9: KEY_37.LED-, KEY_38.LED-, KEY_60.LED-, KEY_61.LED-, KEY_83.LED-, KEY_84.LED-, KEY_105.LED-, KEY_106.LED-, KEY_126.LED-, KEY_127.LED-, KEY_142.LED-, KEY_143.LED-, SJ55.1; also elsewhere on the board
LED_SINK_9_MACRO: KEY_17.LED-, KEY_18.LED-, SJ55.2
LED_SINK_10: KEY_39.LED-, KEY_40.LED-, KEY_62.LED-, KEY_63.LED-, KEY_85.LED-, KEY_86.LED-, KEY_107.LED-, KEY_108.LED-, KEY_128.LED-, KEY_129.LED-, KEY_144.LED-, KEY_145.LED-, SJ56.1; also elsewhere on the board
LED_SINK_10_MACRO: KEY_19.LED-, KEY_20.LED-, SJ56.2
LED_SINK_11: KEY_41.LED-, KEY_42.LED-, KEY_64.LED-, KEY_65.LED-, KEY_87.LED-, KEY_88.LED-, KEY_109.LED-, KEY_110.LED-, KEY_130.LED-, KEY_131.LED-, KEY_146.LED-, KEY_147.LED-, SJ57.1, SJ86.1
LED_SINK_11_CTRL: SJ86.2; also elsewhere on the board
LED_SINK_11_MACRO: KEY_150.LED-, KEY_151.LED-, SJ57.2
LED_SINK_12: KEY_43.LED-, KEY_44.LED-, KEY_66.LED-, KEY_67.LED-, KEY_89.LED-, KEY_90.LED-, KEY_111.LED-, KEY_112.LED-, KEY_132.LED-, KEY_148.LED-, KEY_149.LED-, SJ58.1, SJ87.1
LED_SINK_12_CTRL: SJ87.2; also elsewhere on the board
LED_SINK_12_MACRO: KEY_152.LED-, KEY_153.LED-, SJ58.2
LED_SORUCE_9_NUM: KEY_109.LED+, KEY_111.LED+, SJ73.1
LED_SORUCE_10_XFUNC: KEY_92.LED+, SJ72.2
LED_SOURCE_1_CTRL: SJ83.2; also elsewhere on the board
LED_SOURCE_1_NUM: KEY_150.LED+, KEY_152.LED+, SJ44.1
LED_SOURCE_1_QWERTY: KEY_3.LED+, KEY_5.LED+, KEY_7.LED+, KEY_9.LED+, KEY_11.LED+, KEY_13.LED+, KEY_15.LED+, KEY_17.LED+, KEY_19.LED+, SJ44.2, SJ45.1, SJ83.1
LED_SOURCE_1_XFUNC: KEY_1.LED+, SJ45.2
LED_SOURCE_2_CTRL: SJ84.2; also elsewhere on the board
LED_SOURCE_2_NUM: KEY_151.LED+, KEY_153.LED+, SJ43.1
LED_SOURCE_2_QWERY: KEY_4.LED+, KEY_6.LED+, KEY_8.LED+, KEY_10.LED+, KEY_12.LED+, KEY_14.LED+, KEY_16.LED+, KEY_18.LED+, KEY_20.LED+, SJ43.2, SJ46.1, SJ84.1
LED_SOURCE_2_XFUNC: KEY_2.LED+, SJ46.2
LED_SOURCE_3_NUM: KEY_41.LED+, KEY_43.LED+, SJ61.1
LED_SOURCE_3_QWERTY: KEY_23.LED+, KEY_25.LED+, KEY_27.LED+, KEY_29.LED+, KEY_31.LED+, KEY_31_OFFSET.LED+, KEY_33.LED+, KEY_33_OFFSET.LED+, KEY_35.LED+, KEY_37.LED+, KEY_39.LED+, SJ59.2, SJ61.2; also elsewhere on the board
LED_SOURCE_3_XFUNC: KEY_21.LED+, SJ59.1
LED_SOURCE_4_NUM: KEY_42.LED+, KEY_44.LED+, SJ62.1
LED_SOURCE_4_QWERTY: KEY_24.LED+, KEY_26.LED+, KEY_28.LED+, KEY_30.LED+, KEY_30_OFFSET.LED+, KEY_32.LED+, KEY_32_OFFSET.LED+, KEY_34.LED+, KEY_36.LED+, KEY_38.LED+, KEY_40.LED+, SJ60.2, SJ62.2; also elsewhere on the board
LED_SOURCE_4_XFUNC: KEY_22.LED+, SJ60.1
LED_SOURCE_5_NUM: KEY_64.LED+, KEY_66.LED+, SJ65.1
LED_SOURCE_5_QWERTY: KEY_47.LED+, KEY_49.LED+, KEY_51.LED+, KEY_53.LED+, KEY_55.LED+, KEY_57.LED+, KEY_59.LED+, KEY_60.LED+, KEY_62.LED+, SJ63.2, SJ65.2; also elsewhere on the board
LED_SOURCE_5_XFUNC: KEY_45.LED+, SJ63.1
LED_SOURCE_6_NUM: KEY_65.LED+, KEY_67.LED+, SJ66.1
LED_SOURCE_6_QWERTY: KEY_48.LED+, KEY_50.LED+, KEY_52.LED+, KEY_54.LED+, KEY_56.LED+, KEY_58.LED+, KEY_61.LED+, KEY_63.LED+, SJ64.2, SJ66.2; also elsewhere on the board
LED_SOURCE_6_XFUNC: KEY_46.LED+, SJ64.1
LED_SOURCE_7_NUM: KEY_87.LED+, KEY_89.LED+, SJ69.1
LED_SOURCE_7_QWERTY: KEY_70.LED+, KEY_72.LED+, KEY_74.LED+, KEY_76.LED+, KEY_78.LED+, KEY_80.LED+, KEY_82.LED+, KEY_83.LED+, KEY_85.LED+, SJ67.1, SJ69.2; also elsewhere on the board
LED_SOURCE_7_XFUNC: KEY_68.LED+, SJ67.2
LED_SOURCE_8_NUM: KEY_88.LED+, KEY_90.LED+, SJ70.1
LED_SOURCE_8_QWERTY: KEY_71.LED+, KEY_73.LED+, KEY_75.LED+, KEY_77.LED+, KEY_79.LED+, KEY_81.LED+, KEY_84.LED+, KEY_86.LED+, SJ68.1, SJ70.2; also elsewhere on the board
LED_SOURCE_8_XFUNC: KEY_69.LED+, SJ68.2
LED_SOURCE_9_QWERTY: KEY_93.LED+, KEY_95.LED+, KEY_97.LED+, KEY_99.LED+, KEY_101.LED+, KEY_103.LED+, KEY_105.LED+, KEY_107.LED+, SJ71.1, SJ73.2; also elsewhere on the board
LED_SOURCE_9_XFUNC: KEY_91.LED+, SJ71.2
LED_SOURCE_10_NUM: KEY_110.LED+, KEY_112.LED+, SJ74.1
LED_SOURCE_10_QWERTY: KEY_94.LED+, KEY_96.LED+, KEY_98.LED+, KEY_100.LED+, KEY_102.LED+, KEY_104.LED+, KEY_106.LED+, KEY_108.LED+, SJ72.1, SJ74.2; also elsewhere on the board
LED_SOURCE_11_NUM: KEY_130.LED+, KEY_132.LED+, SJ77.1
LED_SOURCE_11_QWERTY: KEY_115.LED+, KEY_117.LED+, KEY_119.LED+, KEY_121.LED+, KEY_123.LED+, KEY_125.LED+, KEY_126.LED+, KEY_128.LED+, SJ75.1, SJ77.2; also elsewhere on the board
LED_SOURCE_11_XFUNC: KEY_113.LED+, SJ75.2
LED_SOURCE_12_NUM: KEY_131.LED+, SJ78.1
LED_SOURCE_12_QWERTY: KEY_116.LED+, KEY_118.LED+, KEY_120.LED+, KEY_122.LED+, KEY_124.LED+, KEY_127.LED+, KEY_129.LED+, SJ76.1, SJ78.2; also elsewhere on the board
LED_SOURCE_12_XFUNC: KEY_114.LED+, SJ76.2
LED_SOURCE_13_NUM: KEY_146.LED+, KEY_148.LED+, SJ81.1
LED_SOURCE_13_QWERTY: KEY_135.LED+, KEY_137.LED+, KEY_140.LED+, KEY_142.LED+, KEY_144.LED+, SJ79.1, SJ81.2; also elsewhere on the board
LED_SOURCE_13_XFUNC: KEY_133.LED+, SJ79.2
LED_SOURCE_14_NUM: KEY_147.LED+, KEY_149.LED+, SJ82.1
LED_SOURCE_14_QWERTY: KEY_136.LED+, KEY_138.LED+, KEY_139.LED+, KEY_141.LED+, KEY_143.LED+, KEY_145.LED+, SJ80.1, SJ82.2; also elsewhere on the board
LED_SOURCE_14_XFUNC: KEY_134.LED+, SJ80.2
unnamed: D1.3 (C), KEY_1.SW2
unnamed: D2.3 (C), KEY_2.SW2
unnamed: D3.3 (C), KEY_3.SW2
unnamed: D4.3 (C), KEY_4.SW2
unnamed: D5.3 (C), KEY_5.SW2
unnamed: D6.3 (C), KEY_6.SW2
unnamed: D7.3 (C), KEY_7.SW2
unnamed: D8.3 (C), KEY_8.SW2
unnamed: D9.3 (C), KEY_9.SW2
unnamed: D10.3 (C), KEY_10.SW2
unnamed: D31.3 (C), KEY_31.SW2, KEY_31_OFFSET.SW2
unnamed: D11.3 (C), KEY_11.SW2
unnamed: D40.3 (C), KEY_40.SW2
unnamed: D12.3 (C), KEY_12.SW2
unnamed: D39.3 (C), KEY_39.SW2
unnamed: D13.3 (C), KEY_13.SW2
unnamed: D25.3 (C), KEY_25.SW2
unnamed: D14.3 (C), KEY_14.SW2
unnamed: D38.3 (C), KEY_38.SW2
unnamed: D15.3 (C), KEY_15.SW2
unnamed: D35.3 (C), KEY_35.SW2
unnamed: D16.3 (C), KEY_16.SW2
unnamed: D34.3 (C), KEY_34.SW2
unnamed: D17.3 (C), KEY_17.SW2
unnamed: D37.3 (C), KEY_37.SW2
unnamed: D18.3 (C), KEY_18.SW2
unnamed: D30.3 (C), KEY_30.SW2, KEY_30_OFFSET.SW2
unnamed: D19.3 (C), KEY_19.SW2
unnamed: D36.3 (C), KEY_36.SW2
unnamed: D20.3 (C), KEY_20.SW2
unnamed: D33.3 (C), KEY_33.SW2, KEY_33_OFFSET.SW2
unnamed: D23.3 (C), KEY_23.SW2
unnamed: D32.3 (C), KEY_32.SW2, KEY_32_OFFSET.SW2
unnamed: D29.3 (C), KEY_29.SW2
unnamed: D24.3 (C), KEY_24.SW2
unnamed: D28.3 (C), KEY_28.SW2
unnamed: D27.3 (C), KEY_27.SW2
unnamed: D22.3 (C), KEY_22.SW2
unnamed: D26.3 (C), KEY_26.SW2
unnamed: D21.3 (C), KEY_21.SW2
unnamed: D45.3 (C), KEY_45.SW2
unnamed: D41.3 (C), KEY_41.SW2
unnamed: D46.3 (C), KEY_46.SW2
unnamed: D67.3 (C), KEY_67.SW2
unnamed: D66.3 (C), KEY_66.SW2
unnamed: D68.3 (C), KEY_68.SW2
unnamed: D65.3 (C), KEY_65.SW2
unnamed: D64.3 (C), KEY_64.SW2
unnamed: D63.3 (C), KEY_63.SW2
unnamed: D62.3 (C), KEY_62.SW2
unnamed: D61.3 (C), KEY_61.SW2
unnamed: D52.3 (C), KEY_52.SW2
unnamed: D49.3 (C), KEY_49.SW2
unnamed: D60.3 (C), KEY_60.SW2
unnamed: D51.3 (C), KEY_51.SW2
unnamed: D59.3 (C), KEY_59.SW2
unnamed: D58.3 (C), KEY_58.SW2
unnamed: D57.3 (C), KEY_57.SW2
unnamed: D50.3 (C), KEY_50.SW2
unnamed: D48.3 (C), KEY_48.SW2
unnamed: D56.3 (C), KEY_56.SW2
unnamed: D69.3 (C), KEY_69.SW2
unnamed: D55.3 (C), KEY_55.SW2
unnamed: D47.3 (C), KEY_47.SW2
unnamed: D54.3 (C), KEY_54.SW2
unnamed: D90.3 (C), KEY_90.SW2
unnamed: D53.3 (C), KEY_53.SW2
unnamed: D150.3 (C), KEY_150.SW2
unnamed: D89.3 (C), KEY_89.SW2
unnamed: D87.3 (C), KEY_87.SW2
unnamed: D70.3 (C), KEY_70.SW2
unnamed: D88.3 (C), KEY_88.SW2
unnamed: D83.3 (C), KEY_83.SW2
unnamed: D86.3 (C), KEY_86.SW2
unnamed: D71.3 (C), KEY_71.SW2
unnamed: D151.3 (C), KEY_151.SW2
unnamed: D72.3 (C), KEY_72.SW2
unnamed: D84.3 (C), KEY_84.SW2
unnamed: D73.3 (C), KEY_73.SW2
unnamed: D74.3 (C), KEY_74.SW2
unnamed: D85.3 (C), KEY_85.SW2
unnamed: D75.3 (C), KEY_75.SW2
unnamed: D112.3 (C), KEY_112.SW2
unnamed: D76.3 (C), KEY_76.SW2
unnamed: D111.3 (C), KEY_111.SW2
unnamed: D77.3 (C), KEY_77.SW2
unnamed: D110.3 (C), KEY_110.SW2
unnamed: D78.3 (C), KEY_78.SW2
unnamed: D96.3 (C), KEY_96.SW2
unnamed: D79.3 (C), KEY_79.SW2
unnamed: D109.3 (C), KEY_109.SW2
unnamed: D80.3 (C), KEY_80.SW2
unnamed: D113.3 (C), KEY_113.SW2
unnamed: D81.3 (C), KEY_81.SW2
unnamed: D108.3 (C), KEY_108.SW2
unnamed: D82.3 (C), KEY_82.SW2
unnamed: D100.3 (C), KEY_100.SW2
unnamed: D107.3 (C), KEY_107.SW2
unnamed: D106.3 (C), KEY_106.SW2
unnamed: D152.3 (C), KEY_152.SW2
unnamed: D99.3 (C), KEY_99.SW2
unnamed: D105.3 (C), KEY_105.SW2
unnamed: D104.3 (C), KEY_104.SW2
unnamed: D95.3 (C), KEY_95.SW2
unnamed: D103.3 (C), KEY_103.SW2
unnamed: D98.3 (C), KEY_98.SW2
unnamed: D97.3 (C), KEY_97.SW2
unnamed: D102.3 (C), KEY_102.SW2
unnamed: D101.3 (C), KEY_101.SW2
unnamed: D114.3 (C), KEY_114.SW2
unnamed: D94.3 (C), KEY_94.SW2
unnamed: D132.3 (C), KEY_132.SW2
unnamed: D93.3 (C), KEY_93.SW2
unnamed: D153.3 (C), KEY_153.SW2
unnamed: D92.3 (C), KEY_92.SW2
unnamed: D91.3 (C), KEY_91.SW2
unnamed: D131.3 (C), KEY_131.SW2
unnamed: D129.3 (C), KEY_129.SW2
unnamed: D130.3 (C), KEY_130.SW2
unnamed: D128.3 (C), KEY_128.SW2
unnamed: D124.3 (C), KEY_124.SW2
unnamed: D127.3 (C), KEY_127.SW2
unnamed: D125.3 (C), KEY_125.SW2
unnamed: D126.3 (C), KEY_126.SW2
unnamed: D133.3 (C), KEY_133.SW2
unnamed: D123.3 (C), KEY_123.SW2
unnamed: D122.3 (C), KEY_122.SW2
unnamed: D134.3 (C), KEY_134.SW2
unnamed: D121.3 (C), KEY_121.SW2
unnamed: D149.3 (C), KEY_149.SW2
unnamed: D120.3 (C), KEY_120.SW2
unnamed: D42.3 (C), KEY_42.SW2
unnamed: D119.3 (C), KEY_119.SW2
unnamed: D146.3 (C), KEY_146.SW2
unnamed: D118.3 (C), KEY_118.SW2
unnamed: D148.3 (C), KEY_148.SW2
unnamed: D117.3 (C), KEY_117.SW2
unnamed: D144.3 (C), KEY_144.SW2
unnamed: D116.3 (C), KEY_116.SW2
unnamed: D147.3 (C), KEY_147.SW2
unnamed: D145.3 (C), KEY_145.SW2
unnamed: D115.3 (C), KEY_115.SW2
unnamed: D143.3 (C), KEY_143.SW2
unnamed: D135.3 (C), KEY_135.SW2
unnamed: D142.3 (C), KEY_142.SW2
unnamed: D141.3 (C), KEY_141.SW2
unnamed: D140.3 (C), KEY_140.SW2
unnamed: D139.3 (C), KEY_139.SW2
unnamed: D43.3 (C), KEY_43.SW2
unnamed: D138.3 (C), KEY_138.SW2
unnamed: D137.3 (C), KEY_137.SW2
unnamed: D136.3 (C), KEY_136.SW2
unnamed: D44.3 (C), KEY_44.SW2
ROW_1: SJ35.2; also elsewhere on the board
ROW_1_NUM: D150.1 (A), D151.1 (A), D152.1 (A), D153.1 (A), SJ36.1
ROW_1_QWERTY: D3.1 (A), D4.1 (A), D5.1 (A), D6.1 (A), D7.1 (A), D8.1 (A), D9.1 (A), D10.1 (A), D11.1 (A), D12.1 (A), D13.1 (A), D14.1 (A), D15.1 (A), D16.1 (A), D17.1 (A), D18.1 (A), D19.1 (A), D20.1 (A), SJ26.1, SJ35.1, SJ36.2
ROW_1_XFUNC: D1.1 (A), D2.1 (A), SJ26.2
ROW_2_NUM: D41.1 (A), D42.1 (A), D43.1 (A), D44.1 (A), SJ37.1
ROW_2_QWERTY: D23.1 (A), D24.1 (A), D25.1 (A), D26.1 (A), D27.1 (A), D28.1 (A), D29.1 (A), D30.1 (A), D31.1 (A), D32.1 (A), D33.1 (A), D34.1 (A), D35.1 (A), D36.1 (A), D37.1 (A), D38.1 (A), D39.1 (A), D40.1 (A), SJ27.1, SJ37.2; also elsewhere on the board
ROW_2_XFUNC: D21.1 (A), D22.1 (A), SJ27.2
ROW_3_NUM: D64.1 (A), D65.1 (A), D66.1 (A), D67.1 (A), SJ38.1
ROW_3_QWERTY: D47.1 (A), D48.1 (A), D49.1 (A), D50.1 (A), D51.1 (A), D52.1 (A), D53.1 (A), D54.1 (A), D55.1 (A), D56.1 (A), D57.1 (A), D58.1 (A), D59.1 (A), D60.1 (A), D61.1 (A), D62.1 (A), D63.1 (A), SJ28.1, SJ38.2; also elsewhere on the board
ROW_3_XFUNC: D45.1 (A), D46.1 (A), SJ28.2
ROW_4_NUM: D87.1 (A), D88.1 (A), D89.1 (A), D90.1 (A), SJ39.1
ROW_4_QWERTY: D70.1 (A), D71.1 (A), D72.1 (A), D73.1 (A), D74.1 (A), D75.1 (A), D76.1 (A), D77.1 (A), D78.1 (A), D79.1 (A), D80.1 (A), D81.1 (A), D82.1 (A), D83.1 (A), D84.1 (A), D85.1 (A), D86.1 (A), SJ29.1, SJ39.2; also elsewhere on the board
ROW_4_XFUNC: D68.1 (A), D69.1 (A), SJ29.2
ROW_5_NUM: D109.1 (A), D110.1 (A), D111.1 (A), D112.1 (A), SJ40.1
ROW_5_QWERTY: D93.1 (A), D94.1 (A), D95.1 (A), D96.1 (A), D97.1 (A), D98.1 (A), D99.1 (A), D100.1 (A), D101.1 (A), D102.1 (A), D103.1 (A), D104.1 (A), D105.1 (A), D106.1 (A), D107.1 (A), D108.1 (A), SJ30.1, SJ40.2; also elsewhere on the board
ROW_5_XFUNC: D91.1 (A), D92.1 (A), SJ30.2
ROW_6_NUM: D130.1 (A), D131.1 (A), D132.1 (A), SJ41.1
ROW_6_QWERTY: D115.1 (A), D116.1 (A), D117.1 (A), D118.1 (A), D119.1 (A), D120.1 (A), D121.1 (A), D122.1 (A), D123.1 (A), D124.1 (A), D125.1 (A), D126.1 (A), D127.1 (A), D128.1 (A), D129.1 (A), SJ31.1, SJ41.2; also elsewhere on the board
ROW_6_XFUNC: D113.1 (A), D114.1 (A), SJ31.2
ROW_7_NUM: D146.1 (A), D147.1 (A), D148.1 (A), D149.1 (A), SJ42.1
ROW_7_QWERTY: D135.1 (A), D136.1 (A), D137.1 (A), D138.1 (A), D139.1 (A), D140.1 (A), D141.1 (A), D142.1 (A), D143.1 (A), D144.1 (A), D145.1 (A), SJ32.1, SJ42.2; also elsewhere on the board
ROW_7_XFUNC: D133.1 (A), D134.1 (A), SJ32.2

Notes on the sheet:
Cut Point

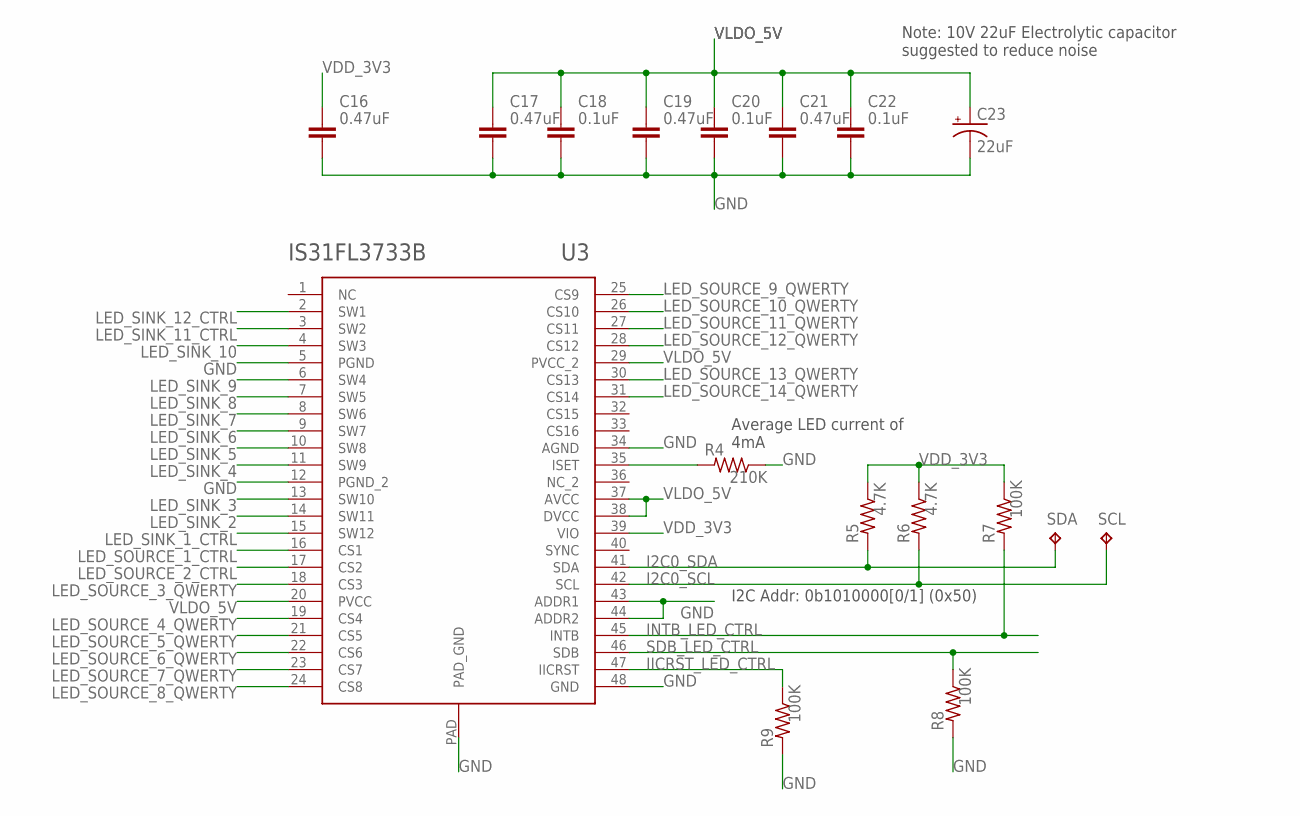
[picture p11: schematic Flexboard.sch, sheet 4, LED Controller]

Parts:
C16, C17, C19, C21: 0.47uF; CAPC2012X110
C18, C20, C22: 0.1uF; CAPC2012X110
C23: 22uF; 860020672011
R4: 210K; RESC2012X65
R5, R6: 4.7K; RESC2012X65
R7, R8, R9: 100K; RESC2012X65
SCL: TPB2,54; B2,54
SDA: TPB2,54; B2,54
U3: IS31FL3733B-TQLS4

Connections:
GND: C16.2, C17.2, C18.2, C19.2, C20.2, C21.2, C22.2, C23.-, R4.1, R8.2, R9.2, U3.5 (PGND), U3.12 (PGND_2), U3.34 (AGND), U3.43 (ADDR1), U3.44 (ADDR2), U3.48 (GND), U3.PAD (PAD_GND); also elsewhere on the board
I2C0_SCL: R6.2, SCL.TP, U3.42 (SCL); also elsewhere on the board
I2C0_SDA: R5.2, SDA.TP, U3.41 (SDA); also elsewhere on the board
IICRST_LED_CTRL: R9.1, U3.47 (IICRST)
INTB_LED_CTRL: R7.2, U3.45 (INTB); also elsewhere on the board
LED_SINK_1_CTRL: U3.15 (SW12); also elsewhere on the board
LED_SINK_2: U3.14 (SW11); also elsewhere on the board
LED_SINK_3: U3.13 (SW10); also elsewhere on the board
LED_SINK_4: U3.11 (SW9); also elsewhere on the board
LED_SINK_5: U3.10 (SW8); also elsewhere on the board
LED_SINK_6: U3.9 (SW7); also elsewhere on the board
LED_SINK_7: U3.8 (SW6); also elsewhere on the board
LED_SINK_8: U3.7 (SW5); also elsewhere on the board
LED_SINK_9: U3.6 (SW4); also elsewhere on the board
LED_SINK_10: U3.4 (SW3); also elsewhere on the board
LED_SINK_11_CTRL: U3.3 (SW2); also elsewhere on the board
LED_SINK_12_CTRL: U3.2 (SW1); also elsewhere on the board
LED_SOURCE_1_CTRL: U3.16 (CS1); also elsewhere on the board
LED_SOURCE_2_CTRL: U3.17 (CS2); also elsewhere on the board
LED_SOURCE_3_QWERTY: U3.18 (CS3); also elsewhere on the board
LED_SOURCE_4_QWERTY: U3.19 (CS4); also elsewhere on the board
LED_SOURCE_5_QWERTY: U3.21 (CS5); also elsewhere on the board
LED_SOURCE_6_QWERTY: U3.22 (CS6); also elsewhere on the board
LED_SOURCE_7_QWERTY: U3.23 (CS7); also elsewhere on the board
LED_SOURCE_8_QWERTY: U3.24 (CS8); also elsewhere on the board
LED_SOURCE_9_QWERTY: U3.25 (CS9); also elsewhere on the board
LED_SOURCE_10_QWERTY: U3.26 (CS10); also elsewhere on the board
LED_SOURCE_11_QWERTY: U3.27 (CS11); also elsewhere on the board
LED_SOURCE_12_QWERTY: U3.28 (CS12); also elsewhere on the board
LED_SOURCE_13_QWERTY: U3.30 (CS13); also elsewhere on the board
LED_SOURCE_14_QWERTY: U3.31 (CS14); also elsewhere on the board
unnamed: R4.2, U3.35 (ISET)
SDB_LED_CTRL: R8.1, U3.46 (SDB); also elsewhere on the board
VDD_3V3: C16.1, R5.1, R6.1, R7.1, U3.39 (VIO); also elsewhere on the board
VLDO_5V: C17.1, C18.1, C19.1, C20.1, C21.1, C22.1, C23.+, U3.20 (PVCC), U3.29 (PVCC_2), U3.37 (AVCC), U3.38 (DVCC); also elsewhere on the board

Notes on the sheet:
Average LED current of 4mA
I2C Addr: 0b1010000[0/1] (0x50)
Note: 10V 22uF Electrolytic capacitor suggested to reduce noise

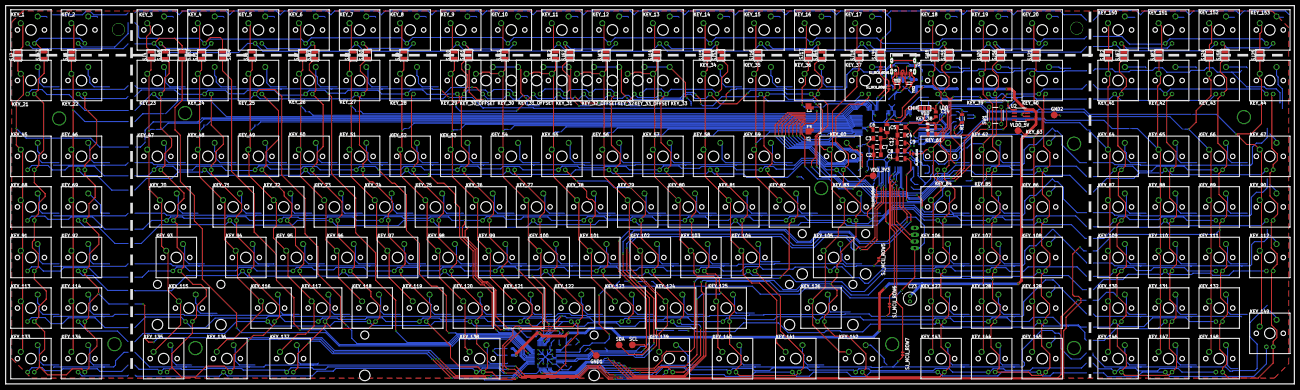
[picture p12: board Flexboard.brd from above]

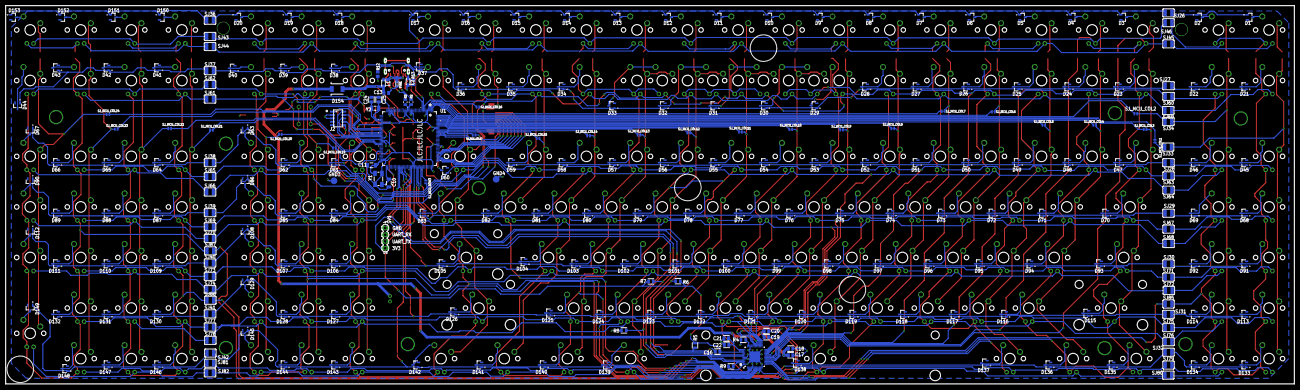
[picture p13: board Flexboard.brd from below]

Board: 2 copper layers, 485.5 x 142.5 mm, 498 parts (258 on the bottom side), 367 nets.
