danieldegrasse/Flexboard/(commit log)

2021-07-25 Initial Commmit: Laid out keys in schematic
    [Flexboard.brd, Flexboard.sch]
2021-07-25 Partially routed schematic. Pattern should duplicate for rest of board.
    [Flexboard.brd, Flexboard.sch]
2021-07-26 Finished schematic wiring for PCB
    [Flexboard.brd, Flexboard.sch]
2021-07-28 Switches laid out, some alignment needs fixing
    [Flexboard.brd, Flexboard.sch]
2021-07-28 Fixed switch alignments
    [Flexboard.brd]
2021-07-28 Routed columns
    [Flexboard.brd]
2021-07-28 Added first few row routes
    [Flexboard.brd]
2021-08-05 Finished routing keyboard switches and diodes
    [Flexboard.brd, Flexboard.sch]
2021-10-04 Routed LED ROW nets
    PCB has not had led traces routed, but LED row nets are routed in
    schematic
    [Flexboard.brd, Flexboard.sch]
2021-10-04 Routed Column Nets for LEDs
    No LED traces routed on board, but all nets are routed for columns and
    rows in schematic
    [Flexboard.brd, Flexboard.sch]
2021-10-04 Solder joints for LEDs laid out on board
    [Flexboard.brd]
2021-10-04 Working on moving rows to bottom layer
    [Flexboard.brd]
2021-10-04 Revert "Working on moving rows to bottom layer"
    This reverts commit 131a86a1cb6fe059613502008a9fd4c9c1a2df1a.
    Decided it was best to leave diodes on top, so that the chip would have
    more space to route in
    [Flexboard.brd]
2021-10-04 Routed LED columns, rows partially routed
    [Flexboard.brd, Flexboard.sch]
2021-10-05 Finished routed LEDs on PCB
    [Flexboard.brd]
2021-10-05 Starting designing trace routing to MCU
    [Flexboard.brd, Flexboard.sch]
2021-10-06 Most columns are routed near the MCU
    [Flexboard.brd]
2021-10-07 Fixed offset keys
    Offset function row keys were offset one key to the right. They are now
    correctly lined up so the breaks between each block of function keys are
    at the right location
    [Flexboard.brd, Flexboard.sch]
2021-10-07 Flipped Column and Row Trace Sides
    Column traces moved to front of board, row traces on rear. This way
    all SMD components are on rear of board.
    [Flexboard.brd]
2021-10-07 Lined up all Solder jumpers on their cut points
    [Flexboard.brd]
2021-10-09 Fixed net naming to use one indexing for rows and columns
    Also fixed naming so that the row wires routed to MCU have useful names
    [Flexboard.brd, Flexboard.sch]
2021-10-09 All traces are now routed near mcu
    [Flexboard.brd]
2021-10-26 Assigned all keyboard traces to pins on MCU
    All traces for columns and rows now have initial pin assignments
    [Flexboard.brd, Flexboard.sch]
2021-11-21 Added jumpers on each column and row trace
    Column and row traces now have jumpers, which are normally
    closed. These jumpers can be used to fix any routing errors,
    by cutting the jumper and patching wires.
    [Flexboard.brd, Flexboard.sch]
2021-11-21 All column and row traces routed to MCU
    All column and row traces are connected to the MCU
    [Flexboard.brd, Flexboard.sch]
2022-02-20 Added usb to MCU and routed power planes
    Added board wide power and ground planes, as well as USB traces to kinetis MCU.
    [Flexboard.brd, Flexboard.sch]
2022-02-24 Routed diodes around usb
    All required diodes and solder bridges for keys are now routed to MCU
    [Flexboard.brd]
2022-03-03 Added decoupling capacitors around the mcu
    added power caps to MCU, 1uF and 100nF
    [Flexboard.brd, Flexboard.sch]
2022-03-04 added oscillators to design
    added 8MHz and 32KHz crystals to design. Still need to add capacitors
    and resistors for USB 5V as well as DP/DN
    [Flexboard.brd, Flexboard.sch]
2022-03-05 added usb 33 ohm resistors
    Added 33 ohm resistors to usb traces, and redid length matching
    [Flexboard.brd, Flexboard.sch]
2022-03-06 added TVS diodes for ESD protection and power source switch
    TVS diodes required for high voltage spike protection, power
    source switch will enable selection of LDO or internal regulator
    [Flexboard.brd, Flexboard.sch]
2022-03-06 added LDO to design
    LDO added, now just need power decoupling caps and diodes
    [Flexboard.brd, Flexboard.sch]
2022-03-12 added all power domain components
    Added schottky diode on 5V LDO power rail to protect LDO. Power domain
    routing should be complete.
    [Flexboard.brd, Flexboard.sch]
2022-04-24 added four media keys
    added four additional media keys to board, and renumbered keys to
    perserve correct numbering sequence.
    [Flexboard.brd, Flexboard.sch]
2022-04-24 added current limiting resistors to LED rows
    current limit resistors should limit LED network to 10mA across each
    LED, for a total of roughly 70mA sourced from the chip.
    [Flexboard.brd, Flexboard.sch]
2022-04-24 cleaned up name locations on board
    cleaned up name locations on board silkscreen to ensure that there will
    not be overlap between board printing and solder pads
    [Flexboard.brd, Flexboard.sch]
2022-05-10 Fixed ERC errors
    Fixed valid ERC errors, and approved remaining overlap warnings as
    nonissues
    [Flexboard.brd, Flexboard.sch]
2022-05-28 ran DRC, fixed majority of errors
    Fixed majority of DRC errors for JLPCB design rules. Still need to
    check dimension and overlap errors on solder bridges.
    [Flexboard.brd, Flexboard.sch]
2022-06-16 added board dimensions and approved remaining DRC issues
    added required board dimensions, and verified remaining DRC issues will
    not cause problems
    [Flexboard.brd]
2022-06-17 added mounting standoffs
    mounting standoffs added for stability
    [Flexboard.brd]
2022-06-23 Add files via upload
    Added standoff locations (blind and thru)
    Added stab mounts for Lshift, Rshift, Enter, must use plate mount stabs for backspace and numenter due to conflict with MCU and bottom right standoff, respectively
    Rearranged some wires to make room for holes
    Resized PCB to max dimensions based off case
    [Flexboard.brd, Flexboard.sch]
2022-06-27 Updated jtag header location
    Updated jtag header location, and also added several solder bridges
    [Flexboard.brd, Flexboard.sch]
2022-07-10 added 5.1k pulldown resistors to CC lines
    Added 5.1k pulldown resistors to CC lines, as required
    for USB-C connection detection for UFP/sink device
    [Flexboard.brd, Flexboard.sch]
2023-01-02 matrix: removed LED routings
    Removed all LED routings. This is the first step in transitioning
    the keyboard from controlling LEDs using the MCU to using a dedicated
    LED controller IC.
    [Flexboard.brd, Flexboard.sch]
2023-01-29 routed LED controller source and sink lines
    Routed LED controller source and sink lines. Note that due to
    updating to Autodesk Fusion, these files are backwards compatible
    exports from that program.
    Added JLCPCB DRC, as well as LED controller and LDO eagle libraries.
    [Flexboard.brd, Flexboard.sch]
2023-03-07 Added gerber files, sent for production
    Added gerber files. The board updates here are generated from
    Fusion360, which was used to complete the remainder of this project.
    [BOM.xlsx, Flexboard.brd, Flexboard.sch]
2023-03-09 updated BOM with parts on hand
    Updated BOM with parts on hand prior to mouser order, to prevent
    ordering duplicate parts that aren't needed.
    [BOM.xlsx]
2023-06-17 board: added layout PDF
    Added layout PDF, to make component placement easier without opening
    layout editor.
